bakirrayan/screen_support/Images/Animation_rotation_inclinaison.gif

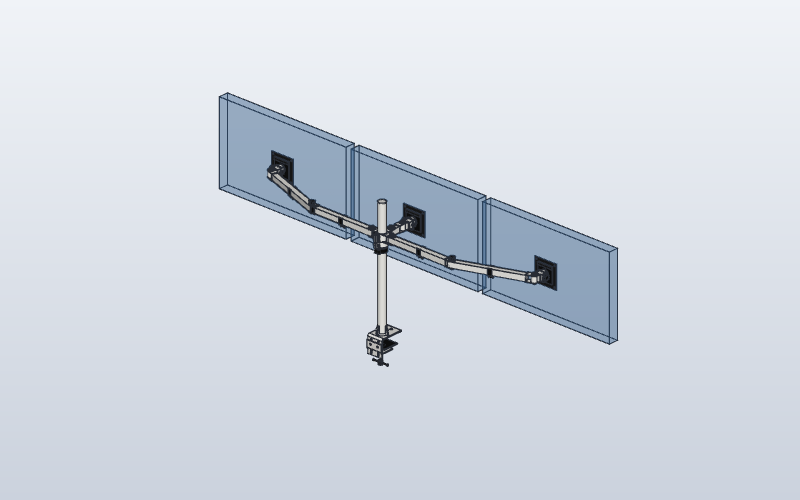
Images/Animation_rotation_inclinaison.gif
