bakirrayan/screen_support/Plans_Support_ecrans.pdf

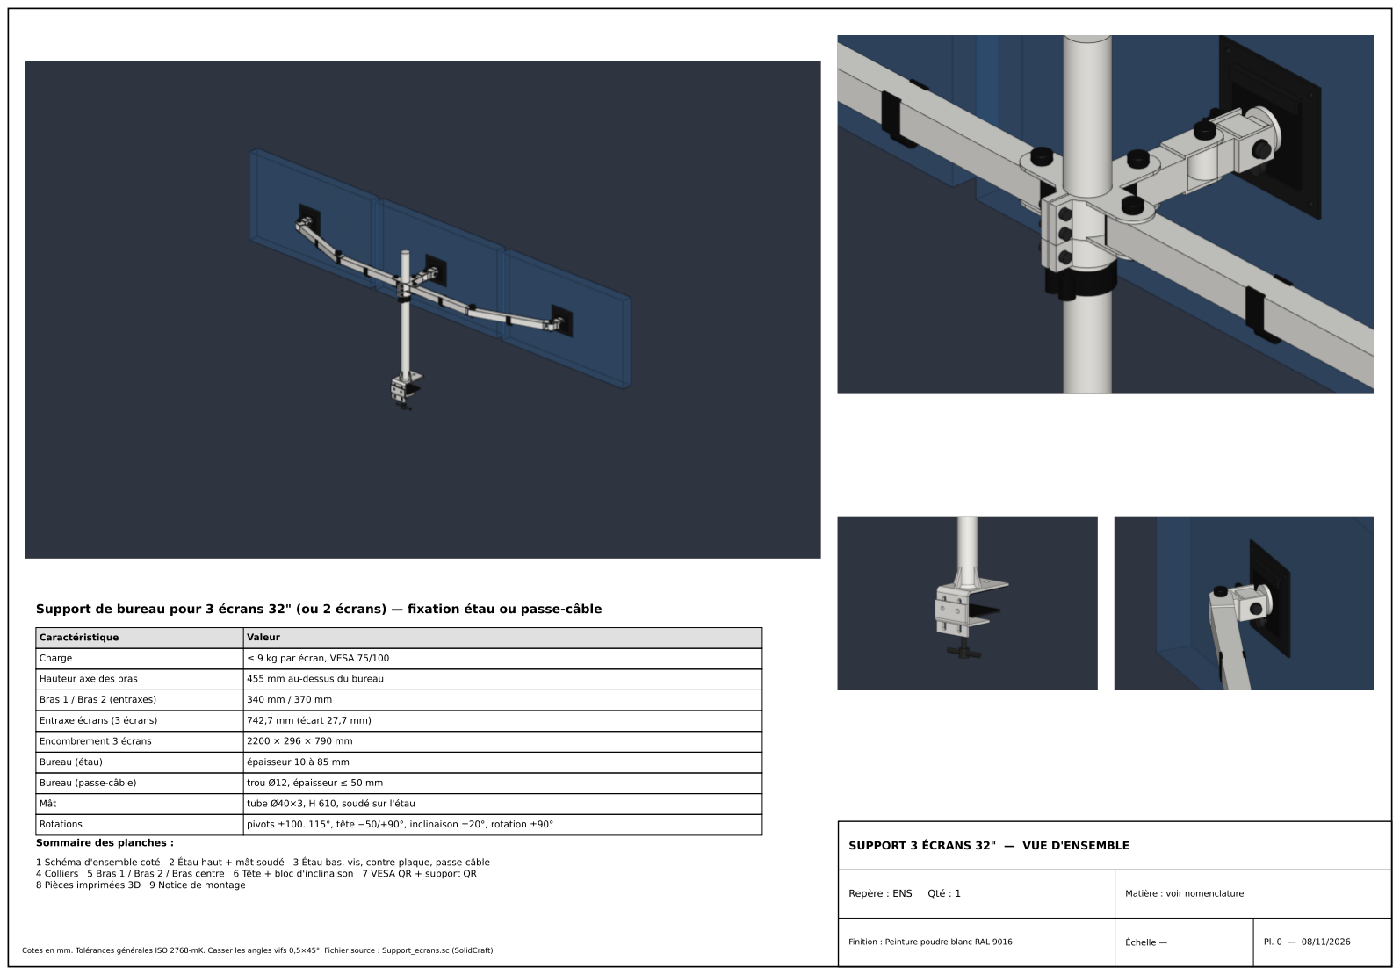
[picture p2: page 1]

### SUPPORT 3 ÉCRANS 32" — VUE D'ENSEMBLE

Repère : ENS Qté : 1 | Matière : voir nomenclature
Finition : Peinture poudre blanc RAL 9016 | Échelle — | Pl. 0 — 08/11/2026

Cotes en mm. Tolérances générales ISO 2768-mK. Casser les angles vifs 0,5×45°. Fichier source : Support_ecrans.sc (SolidCraft)

## Support de bureau pour 3 écrans 32" (ou 2 écrans) — fixation étau ou passe-câble

Caractéristique | Valeur
Charge | ≤ 9 kg par écran, VESA 75/100
Hauteur axe des bras | 455 mm au-dessus du bureau
Bras 1 / Bras 2 (entraxes) | 340 mm / 370 mm
Entraxe écrans (3 écrans) | 742,7 mm (écart 27,7 mm)
Encombrement 3 écrans | 2200 × 296 × 790 mm
Bureau (étau) | épaisseur 10 à 85 mm
Bureau (passe-câble) | trou Ø12, épaisseur ≤ 50 mm
Mât | tube Ø40×3, H 610, soudé sur l'étau
Rotations | pivots ±100..115°, tête −50/+90°, inclinaison ±20°, rotation ±90°

Sommaire des planches :

1 Schéma d'ensemble coté 2 Étau haut + mât soudé 3 Étau bas, vis, contre-plaque, passe-câble
4 Colliers 5 Bras 1 / Bras 2 / Bras centre 6 Tête + bloc d'inclinaison 7 VESA QR + support QR 8 Pièces imprimées 3D 9 Notice de montage

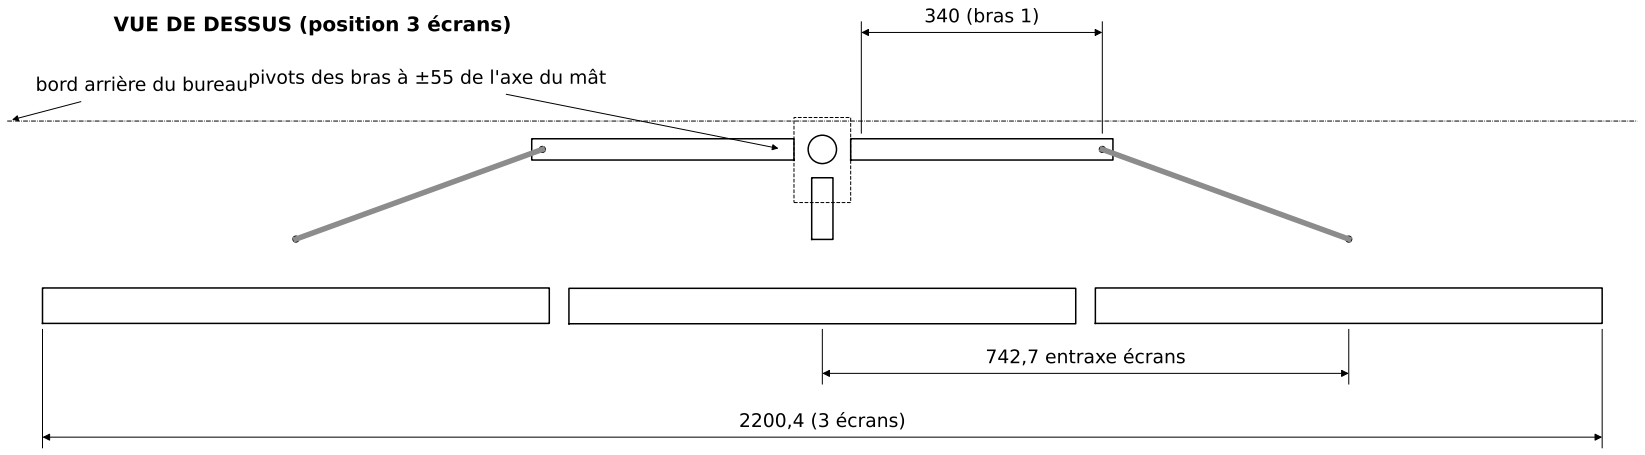
[picture p3: figure]
VUE DE DESSUS (position 3 écrans); bord arrière du bureau; 340 (bras 1); 2200,4 (3 écrans); 742,7 entraxe écrans; pivots des bras à ±55 de l'axe du mât
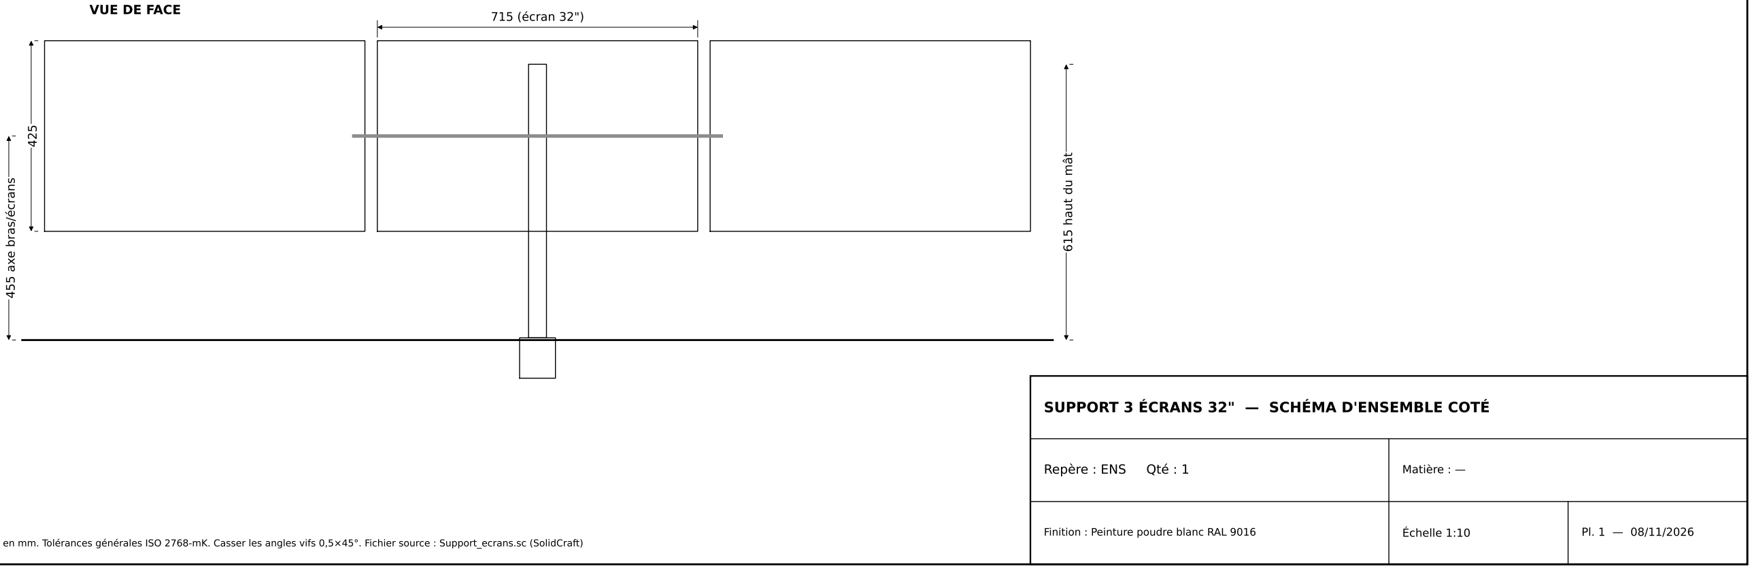
[picture p4: figure]
Repère : ENS; Qté : 1; Matière : —; VUE DE FACE; 455 axe bras/écrans; 615 haut du mât; 715 (écran 32")

### SUPPORT 3 ÉCRANS 32" — SCHÉMA D'ENSEMBLE COTÉ

Finition : Peinture poudre blanc RAL 9016 | Échelle 1:10 | Pl. 1 — 08/11/2026

Positions de réglage :

Articulation | 3 écrans | 2 écrans | Butées
Pivot mât D / G | 0° | +26,7° / −26,7° | −100 / +115 (G inversé)
Coude D / G | −20° / +20° | −113,4° / +113,4° | ±115°
Pivot tête D / G | +20° / −20° | +86,7° / −86,7° | −50 / +90 (G inversé)
Pivot mât centre | 0° | bras retiré | ±110°
Pivot tête centre | 0° | — | ±50°
Inclinaison | 0° | 0° | ±20°
Rotation écran | 0° | 0° | ±90° (portrait)

En mode 2 écrans, les écrans sont avancés de 90 mm vers
l'utilisateur (centres à ±380 mm) : les coudes passent 210 mm
derrière le bord du bureau — prévoir ce dégagement au mur.

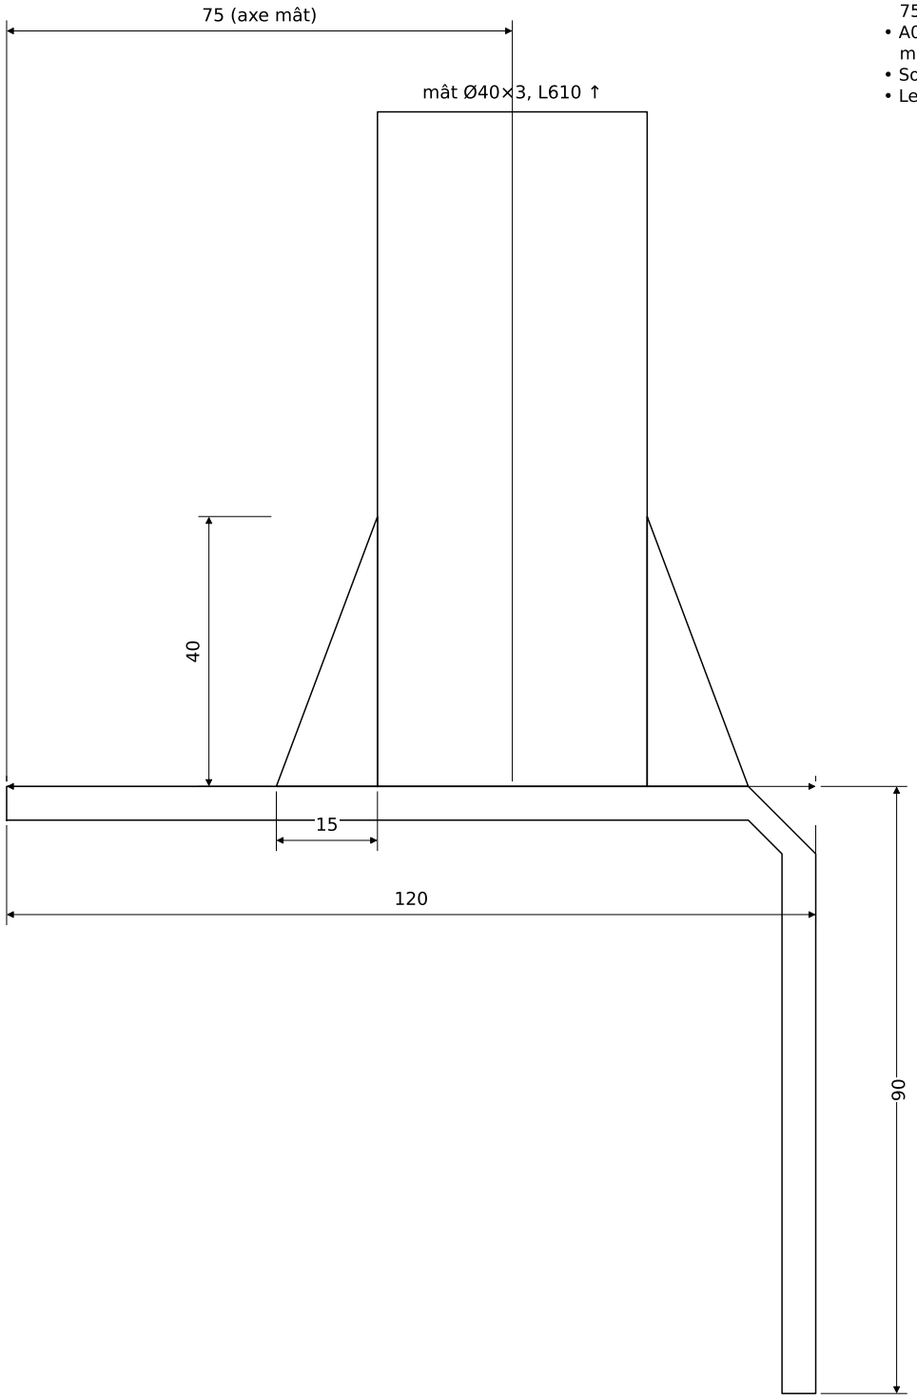
[picture p5: figure]
mât Ø40×3, L610 ↑; 75 (axe mât)
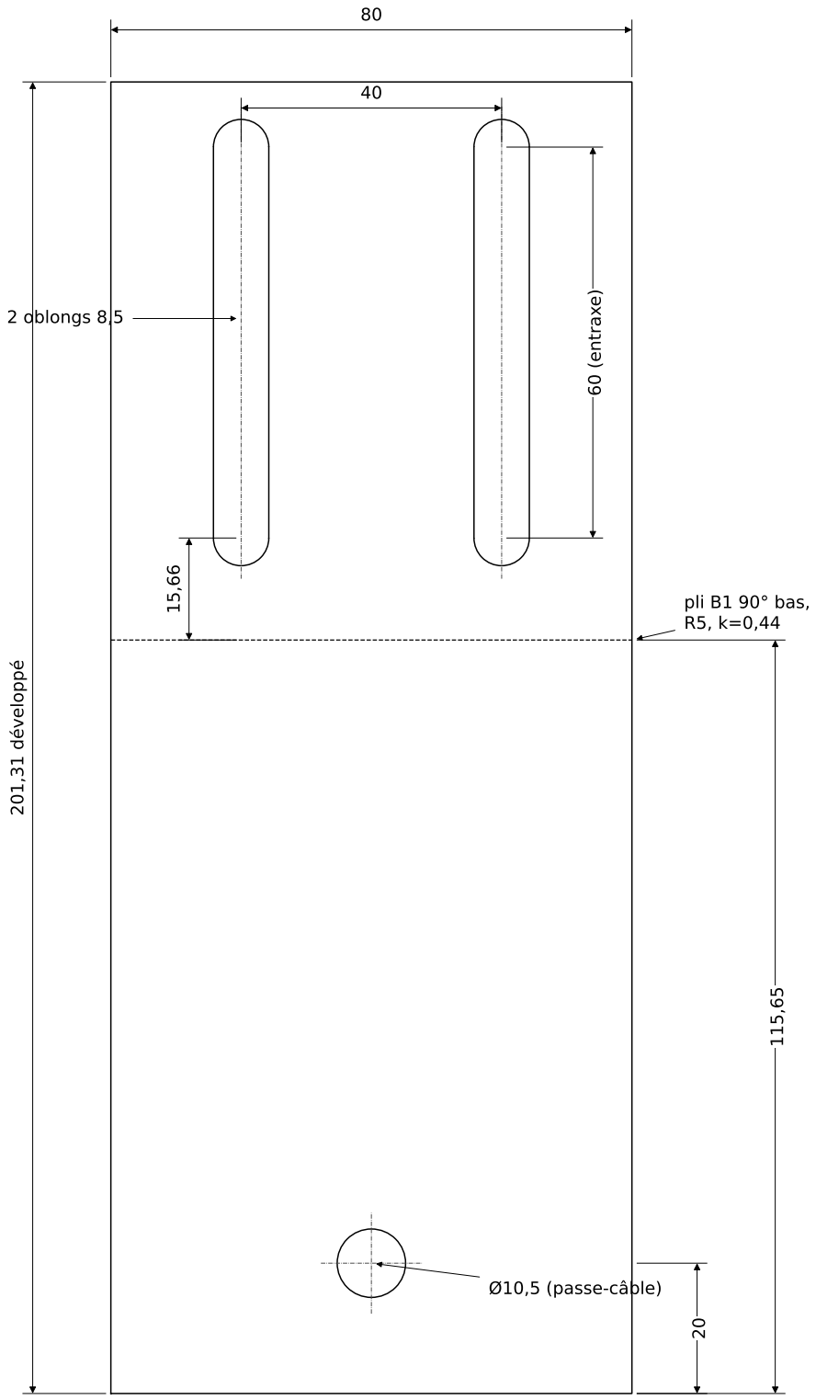
[picture p6: figure]
pli B1 90° bas, R5, k=0,44; 201,31 développé; 60 (entraxe); 2 oblongs 8,5; Ø10,5 (passe-câble)

### SUPPORT 3 ÉCRANS 32" — ÉTAU HAUT + MÂT SOUDÉ

Repère : A01-A04 | Qté : 1 | Matière : Acier S235
Finition : Peinture poudre blanc RAL 9016 | Échelle 1:1 (impr. A3) | Pl. 2 — 08/11/2026

A01 DÉVELOPPÉ — tôle 5 mm (fichier T01)

A01 PLIÉ + A03 MÂT + A04 GOUSSETS (vue de côté)

Notes de fabrication :
- A01 : laser tôle S235 ép. 5 (DXF T01),
pli 90° R5 vers le bas.
- A03 Mât : tube rond Ø40×3 S235, longueur 610, obturer le haut par un disque Ø34 ép. 5 soudé (ou bouchon plastique Ø40).
- Soudure mât/étau : cordon d'angle a=4 (gorge) tout autour. Axe du mât à
75 mm du bord côté utilisateur (45 mm du dos du pli), centré en largeur.
- A04 Goussets ×4 : triangles 15×40 ép. 5 (DXF T03) à 0/90/180/270°, soudés mât + plaque (a=3). Le gousset arrière s'arrête avant le pli.
- Souder AVANT peinture ; vérifier la perpendicularité du mât (≤0,5 mm / 600).
- Le trou Ø10,5 ne sert qu'en montage passe-câble.

### SUPPORT 3 ÉCRANS 32" — ÉTAU BAS, VIS, CONTRE-PLAQUE, PASSE-CÂBLE

Repère : A02, A14-A16 | Qté : 1 | Matière : Acier S235
Finition : Peinture poudre blanc RAL 9016 | Échelle 1:1 / 0,8:1 | Pl. 3 — 08/11/2026

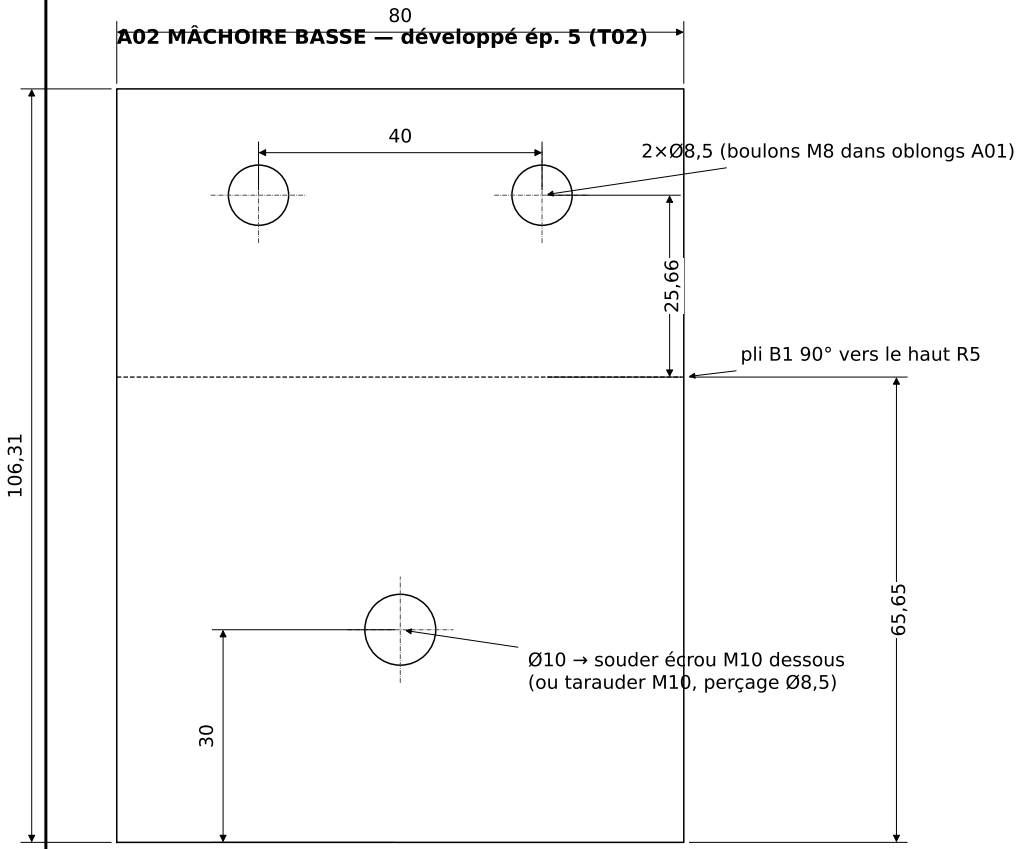
[picture p7: figure]
pli B1 90° vers le haut R5; Ø10 → souder écrou M10 dessous; (ou tarauder M10, perçage Ø8,5); 2×Ø8,5 (boulons M8 dans oblongs A01)

A02 MÂCHOIRE BASSE — développé ép. 5 (T02)

A16 VIS DE SERRAGE (ou achat : vis M10 à patin + poignée) 65 ⁽M¹⁰⁾

A14 CONTRE-PLAQUE 90×80×3 (T13)

90

80

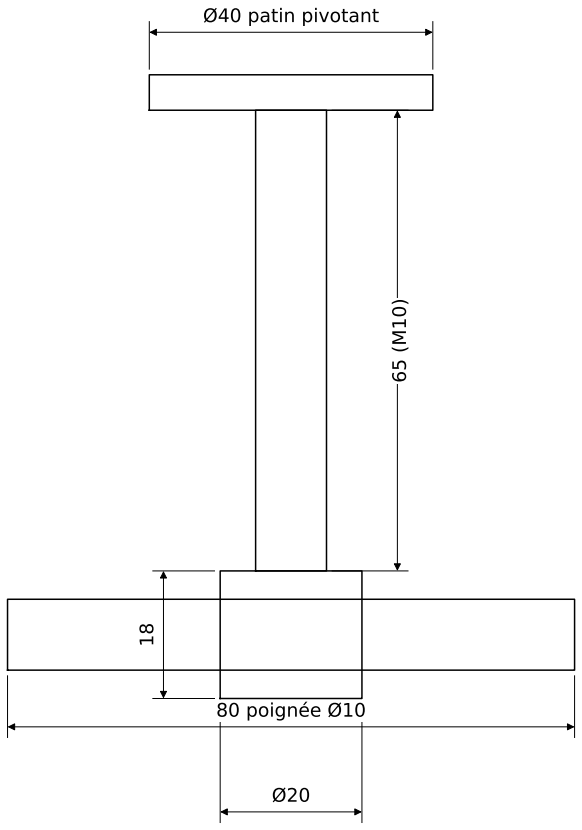
[picture p8: figure]
Ø40 patin pivotant; 80 poignée Ø10

+ patin caoutchouc/TPU 90×80×2 (P13) collé côté bureau

A15 PLAQUE PASSE-CÂBLE 80×60×5 (T14) 80

60

15

Montage étau : A02 se règle dans les oblongs de A01 (boulons M8×20 + écrous nylstop) pour un
bureau de 10 à 85 mm. Patin TPU 76×106×2 (P12) collé sous A01. Contre-plaque A14 entre vis et bureau. Montage passe-câble : tige filetée M10 L70 + 2 écrous M10 + rondelles, plaque A15 sous le bureau (trou Ø12).

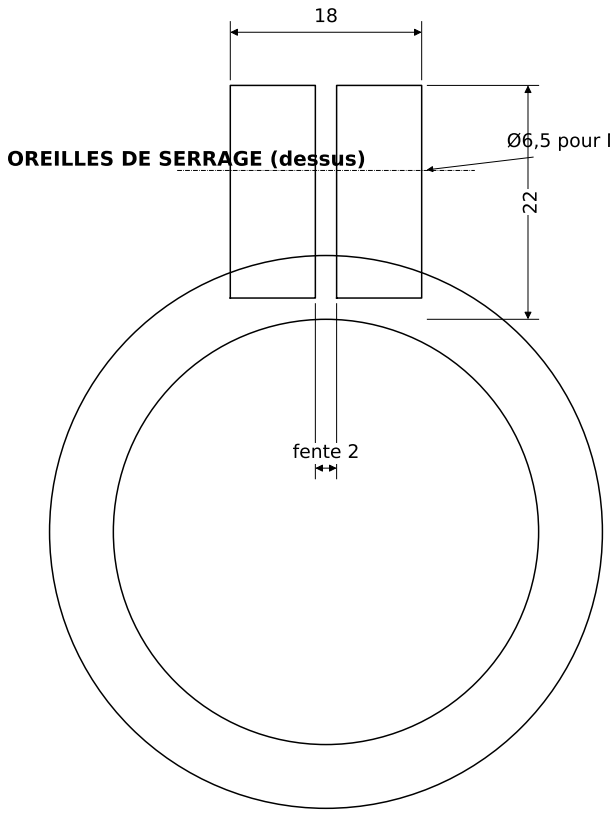
[picture p9: figure]
OREILLES DE SERRAGE (dessus); fente 2

### SUPPORT 3 ÉCRANS 32" — COLLIERS DE MÂT

Repère : A05, A06 | Qté : 1 + 1 | Matière : Acier S235
Finition : Peinture poudre blanc RAL 9016 | Échelle 1:1 / 1,5:1 | Pl. 4 — 08/11/2026

A05 CHAPE DE COLLIER ×2 — ép. 3 (T04) — vue de dessus

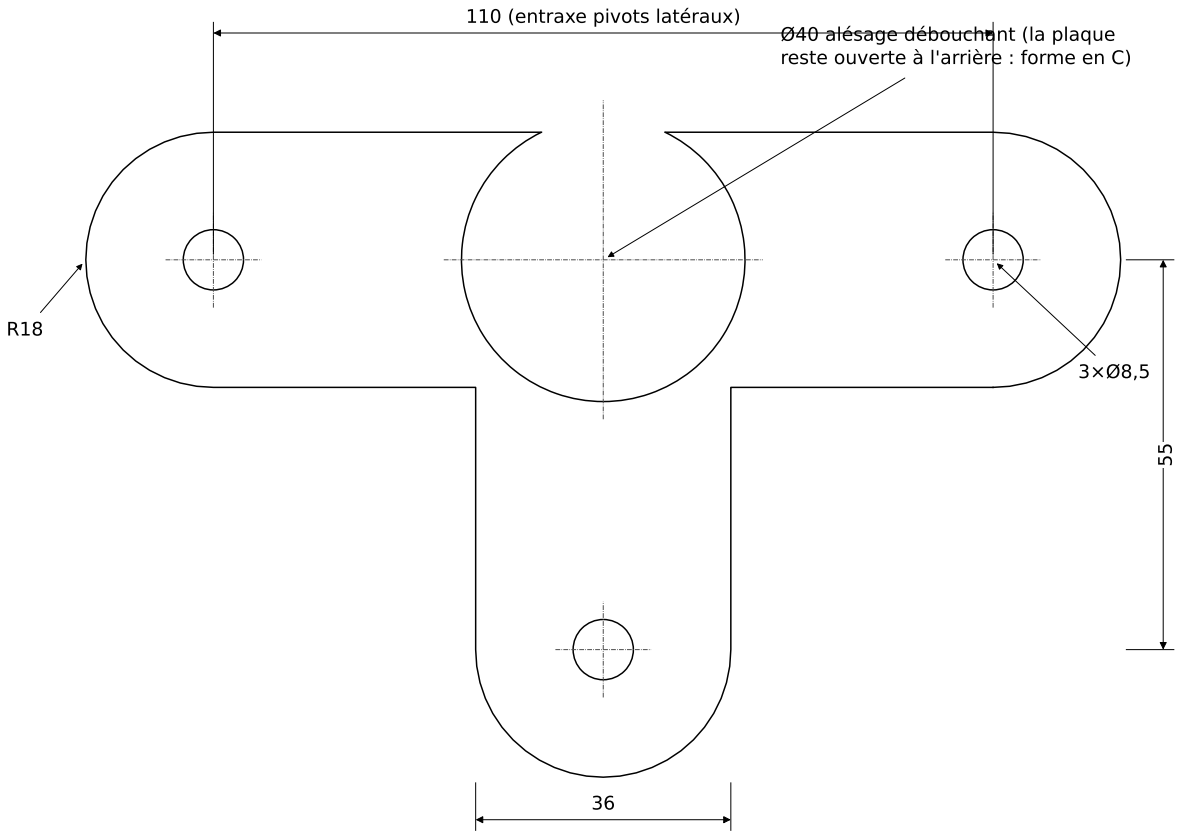
[picture p10: figure]
110 (entraxe pivots latéraux); Ø40 alésage débouchant (la plaque reste ouverte à l'arrière : forme en C)

A05 COLLIER HAUT soudé — vue de face (z)

36

Ø52 / Ø40 (tube 52×6)

30 (passage tube)

Ø6,5 pour M6 (×2 haut, ×1 bas)

Fabrication A05 (collier haut, porte-bras) :

- Bague : tube Ø52×6 (ou rond usiné) Ø52/Ø40 H30, entre les 2 chapes.
- 2 chapes T04 ép. 3 soudées sur les faces de la bague (H totale 36).
- Oreilles : plat 18×20×36 soudé à l'arrière (axe +Y), puis scier
la fente de 2 mm à travers oreilles + bague (après soudure).
- Percer 2×Ø6,5 à 9 et 27 du bas, à 34 mm de l'axe du mât.
- Les 3 pivots Ø8,5 reçoivent les vis M8 + bagues nylon des bras.

Fabrication A06 (collier bas, butée) :
- Bague Ø52/Ø40 H25 + oreilles 18×20×25, fente 2 mm,
1 trou Ø6,5 à 12,5 du bas. Monté juste sous A05.
- Serrer M6 à 8 N·m ; ajouter une bande de chambre à air dans l'alésage pour éviter de marquer le mât.

### SUPPORT 3 ÉCRANS 32" — BRAS 1, BRAS 2, BRAS CENTRE

Repère : A07, A08, A09 | Qté : 2 + 2 + 1 | Matière : Tube carré S235 30×30×2 + tôle 3
Finition : Peinture poudre blanc RAL 9016 | Échelle 1:2 / 1:1 / 2:1 | Pl. 5 — 08/11/2026

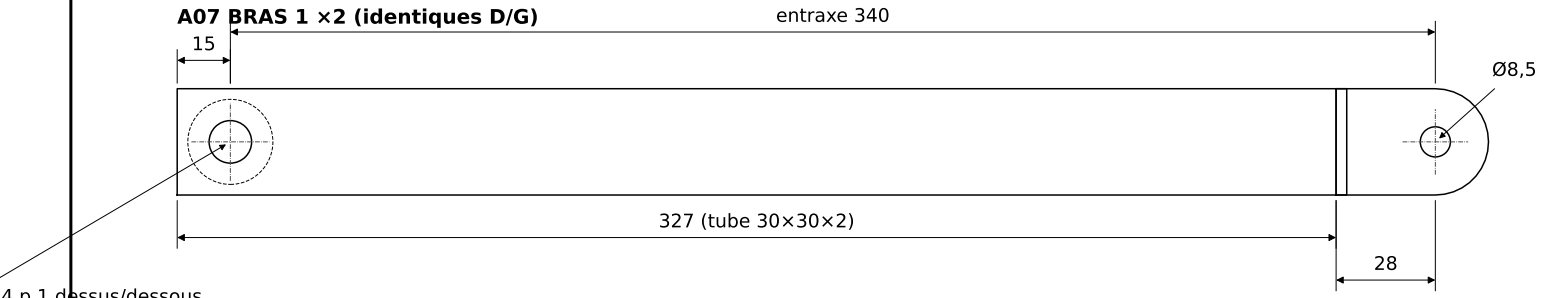
[picture p11: figure]
A07 BRAS 1 ×2 (identiques D/G); 327 (tube 30×30×2); entraxe 340

Ø12 traversant + lamage Ø24 p.1 dessus/dessous

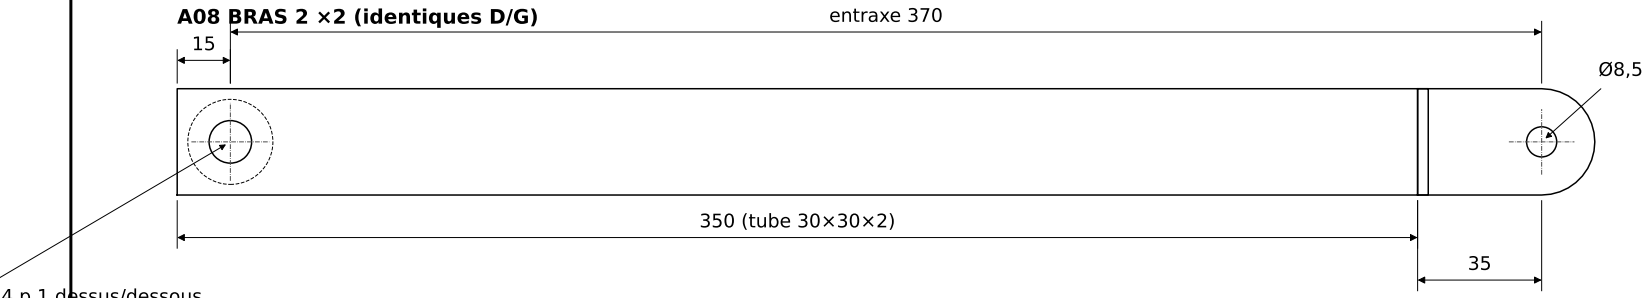
[picture p12: figure]
A08 BRAS 2 ×2 (identiques D/G); 350 (tube 30×30×2); entraxe 370

Ø12 traversant + lamage Ø24 p.1 dessus/dessous

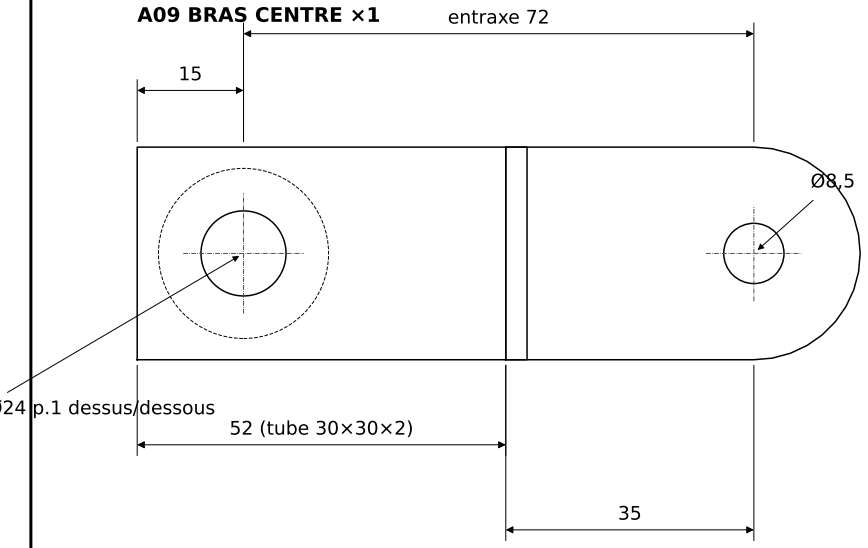
[picture p13: figure]
A09 BRAS CENTRE ×1; 52 (tube 30×30×2); entraxe 72

Ø12 traversant + lamage Ø24 p.1 dessus/dessous

COUPE CHAPE (dos + 2 ailes)

30 int.
36

Fabrication :

- Tubes carrés 30×30×2 S235 coupés d'équerre ; extrémité libre fermée par embout plastique P08 (côté pivot).
- Chape = 2 ailes ép. 3 (T05 pour bras 1 : axe à 28 ; T06 pour bras 2
et centre : axe à 35) + fond 30×30 ép. 3 (T07), soudés au bout du tube. Écartement intérieur des ailes : 30 mm exactement (gabarit de soudage).
- Trou pivot Ø12 à 15 mm du bout libre, traversant les 2 parois horizontales, lamage Ø24 profondeur 1 sur chaque face (patins P04).
- Bague nylon P01 Ø12/Ø8 × 30 dans le tube (sert d'entretoise :
empêche d'écraser le tube au serrage).
- Clips de câbles P11 : bras 1 à 180 mm, bras 2 à 190 mm du pivot.

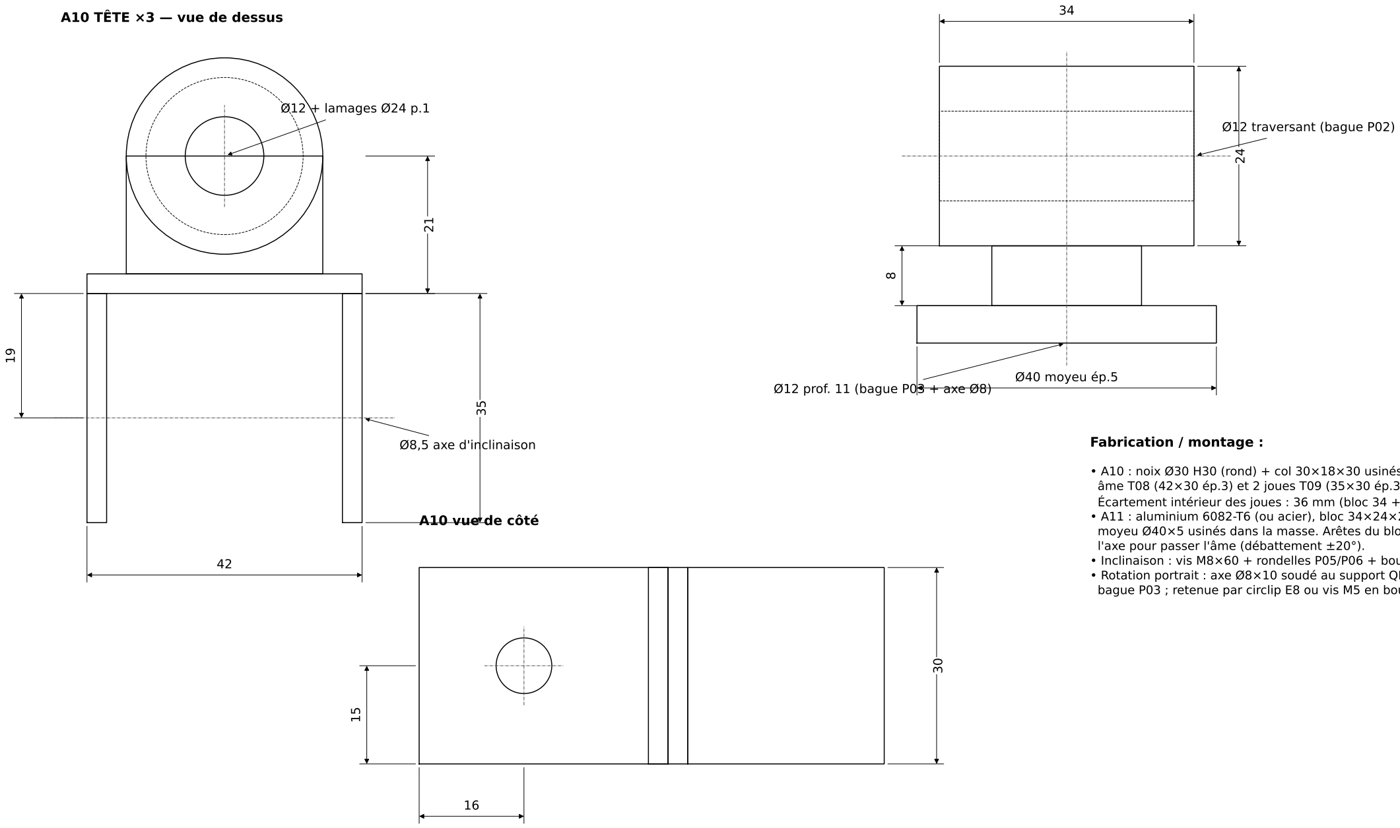
[picture p14: figure]
A10 TÊTE ×3 — vue de dessus; Ø12 + lamages Ø24 p.1; Ø8,5 axe d'inclinaison; A10 vue de côté; Ø40 moyeu ép.5; Ø12 traversant (bague P02); Ø12 prof. 11 (bague P03 + axe Ø8); Fabrication / montage :

### SUPPORT 3 ÉCRANS 32" — TÊTE PIVOTANTE + BLOC D'INCLINAISON

Repère : A10, A11 | Qté : 3 + 3 | Matière : Acier S235 / Alu 6082
Finition : Peinture poudre blanc RAL 9016 | Échelle 1,4:1 / 1,6:1 | Pl. 6 — 08/11/2026

A11 BLOC D'INCLINAISON ×3 (usiné) — dessus

- A10 : noix Ø30 H30 (rond) + col 30×18×30 usinés d'une pièce (ou soudés), âme T08 (42×30 ép.3) et 2 joues T09 (35×30 ép.3, Ø8,5) soudées en U. Écartement intérieur des joues : 36 mm (bloc 34 + 2 rondelles 1 mm).
- A11 : aluminium 6082-T6 (ou acier), bloc 34×24×24 + col 20×8×20 + moyeu Ø40×5 usinés dans la masse. Arêtes du bloc à 17 mm max de l'axe pour passer l'âme (débattement ±20°).
- Inclinaison : vis M8×60 + rondelles P05/P06 + bouton P09 (écrou M8 noyé).
- Rotation portrait : axe Ø8×10 soudé au support QR, tourne dans la
bague P03 ; retenue par circlip E8 ou vis M5 en bout (à ajouter).

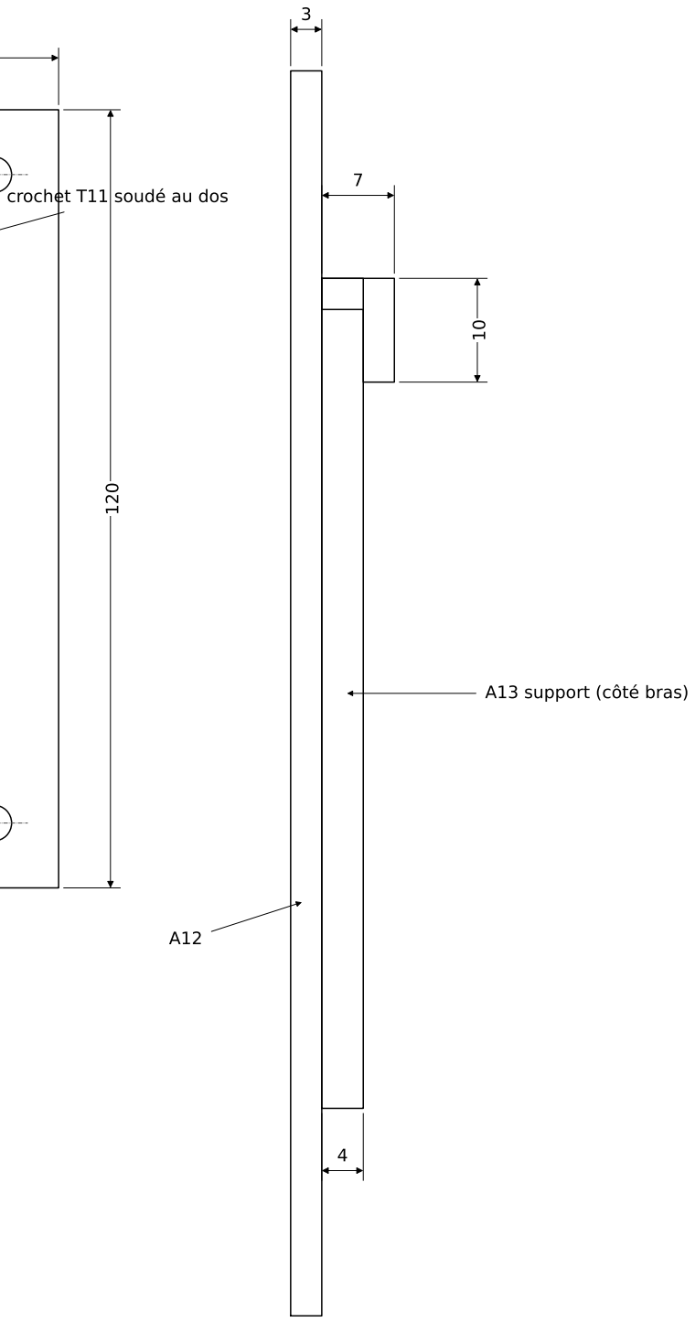
[picture p15: figure]
crochet T11 soudé au dos; A13 support (côté bras)
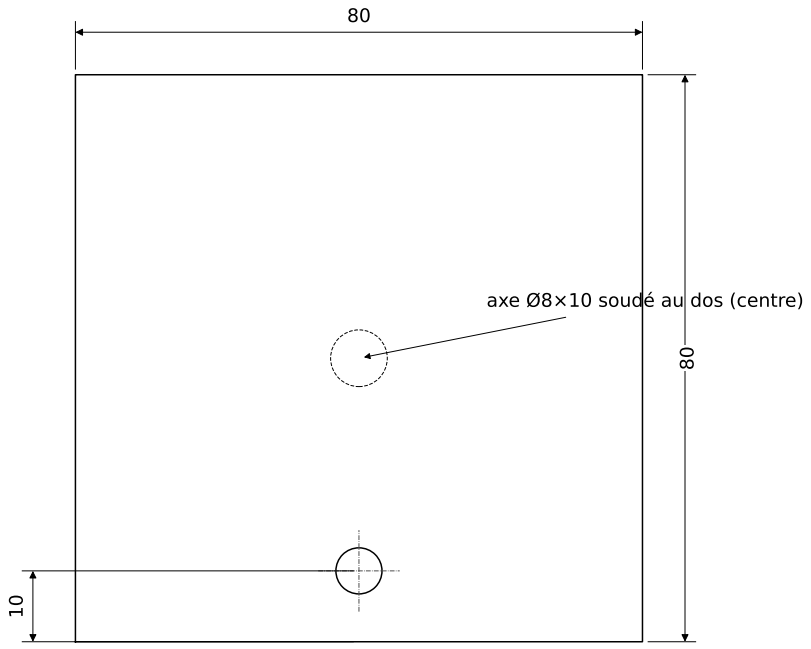
[picture p16: figure]
axe Ø8×10 soudé au dos (centre)

### SUPPORT 3 ÉCRANS 32" — FIXATION VESA À DÉGAGEMENT RAPIDE

Repère : A12, A13 | Qté : 3 + 3 | Matière : Acier S235
Finition : Peinture poudre blanc RAL 9016 | Échelle 1:1 / 1,6:1 | Pl. 7 — 08/11/2026

A12 PLAQUE VESA ×3 (côté écran) — ép. 3 (T10)

COUPE DU CROCHET (A12 + A13)

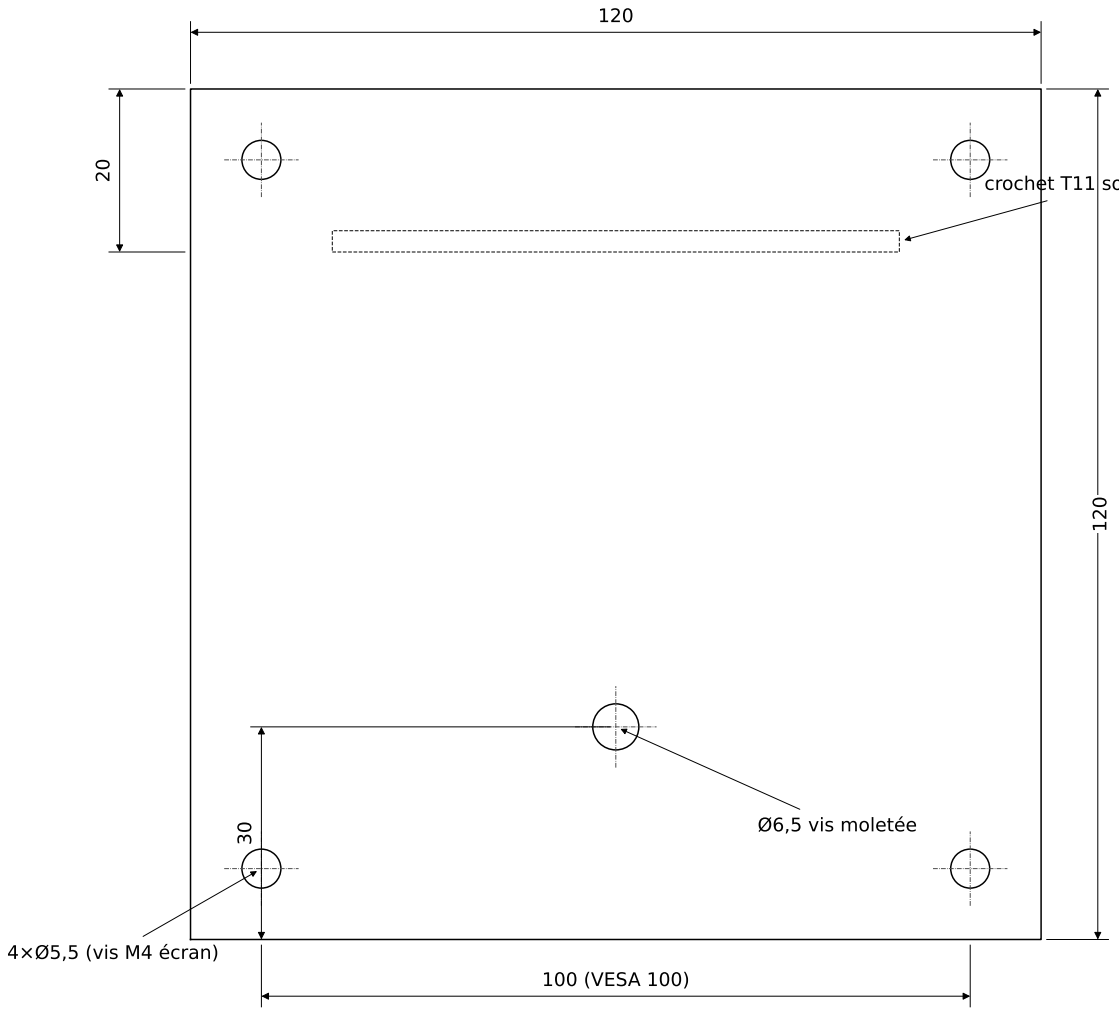
[picture p17: figure]
100 (VESA 100); 4×Ø5,5 (vis M4 écran); Ø6,5 vis moletée

A13 SUPPORT QR ×3 — ép. 4 (T12)

Principe : la plaque A12 reste vissée sur l'écran (VESA 100, ou 75 en ajoutant 4 trous à 75).
On accroche le crochet sur le bord supérieur du support A13, puis on bloque avec la vis moletée M6 (P-QR). Pour VESA 75 : percer 4×Ø5,5 sur un carré de 75 centré.

### SUPPORT 3 ÉCRANS 32" — PIÈCES IMPRIMÉES 3D

Repère : P01-P13 Qté : voir tableau | Matière : PETG / PA / TPU
Finition : Noir | Échelle — | Pl. 8 — 08/11/2026
Rep | Pièce | Qté | Dimensions | Matière | Remplissage / orientation
P01 | Bague pivot | 8 | Ø12 / Ø8 × 30 | PA12 / PETG | 100 %, debout
P02 | Bague inclinaison | 3 | Ø12 / Ø8 × 34 | PA12 / PETG | 100 %, debout
P03 | Bague rotation | 3 | Ø12 / Ø8 × 10 | PA12 / PETG | 100 %, debout
P04 | Patin de friction | 16 | Ø24 / Ø12 × 1 | PETG / PA | 100 %, à plat
P05 | Rondelle de friction | 22 | Ø16 / Ø8,5 × 2 | PETG / PA | 100 %, à plat
P06 | Rondelle de butée | 6 | Ø16 / Ø8,5 × 1 | PETG / PA | 100 %, à plat
P07 | Cache de vis | 6 | Ø18 × 7 (cavité Ø13,5) | PETG | 30 %, dôme en haut
P08 | Embout de tube | 5 | 30×30 col 2 + bouchon 25×25×8 | PETG / TPU | 30 %, col à plat
P09 | Bouton de serrage | 5 | Ø28 × 12, 6 lobes | PETG | 40 %, cavité en bas
P10 | Clip câbles mât | 1 | Ø48/Ø40 × 20, 2 boucles Ø9 | PETG | 30 %, debout
P11 | Clip câbles bras | 4 | U 33 × 49,5 × 20, boucle Ø11 | PETG | 30 %, sur le côté
P12 | Patin d'étau | 1 | 76 × 106 × 2, trou Ø12 | TPU 95A | 100 %, à plat
P13 | Patin contre-plaque | 1 | 90 × 80 × 2 | TPU 95A | 100 %, à plat

Réglages d'impression conseillés :

- Buse 0,4, couches 0,2 (0,12 pour P04/P06 de 1 mm). Périmètres 4 minimum sur les bagues et boutons.
- Bagues P01-P03 : imprimer debout (axe vertical), PA12/PA-CF ou PETG ; aléser à Ø8,0 (forêt 8 mm à la main)
et vérifier Ø12,0 extérieur (ajuster le facteur d'expansion horizontale si l'emmanchement est trop dur).
- Patins P04 et rondelles P05/P06 : PETG ou PA (meilleur frottement : PA/POM usiné ou rondelles PTFE du commerce).
- Boutons P09 : noyer un écrou M8 (h 6,5) dans la cavité Ø13,5 — pause à 5,5 mm ou coller à l'époxy.
- Patins P12/P13 : TPU 95A, 100 % ; à coller (colle contact) sous l'étau et sur la contre-plaque.
- Les STL sont dans le dossier STL ; le nom indique la quantité (_x8 = 8 pièces).

### SUPPORT 3 ÉCRANS 32" — NOTICE DE MONTAGE

Repère : — Qté : — | Matière : —
Finition : Peinture poudre blanc RAL 9016 | Échelle — | Pl. 9 — 08/11/2026
1. PRÉPARATION
Découper / plier / souder les pièces A01-A16 (planches 2-7), ébavurer, peindre. Imprimer P01-P13. Vérifier : mât perpendiculaire à l'étau, écartement des chapes 30 mm, joues de tête 36 mm.
2. FIXATION AU BUREAU (choisir)
Étau : coller P12 sous A01. Poser A01 sur le bureau (dos du pli contre le chant arrière), positionner A02
dans les oblongs pour l'épaisseur du bureau, serrer 2 boulons M8×20 (20 N·m). Poser A14+P13 sous le bureau,
visser A16 jusqu'au contact puis serrer fermement à la main (poignée en T).
Passe-câble : percer Ø12 dans le bureau, passer la tige M10 par le trou Ø10,5 de A01, plaque A15 dessous, écrous M10 (25 N·m).
3. COLLIERS
Glisser A06 (collier bas) puis A05 (collier haut) sur le mât. Régler la hauteur (axe des bras 455 mm),
serrer A06 (M6, 8 N·m), poser A05 dessus, l'orienter (pivot central vers l'utilisateur), serrer ses 2 vis M6.
4. BRAS
Dans chaque pivot : bague P01 dans le tube, patins P04 dans les lamages, rondelles P05 sous tête et écrou. Bras 1 D/G dans les chapes latérales du collier, bras centre dans la chape avant (vis M8×50 + écrou nylstop). Bras 2 dans la chape du coude (vis M8×50 + bouton P09). Têtes A10 dans les chapes de bout (M8×50 + nylstop). Serrage pivots : jusqu'à ce que le bras tienne sa position avec l'écran (≈ 6-8 N·m) — ajuster ensuite.
5. INCLINAISON ET ROTATION
Bloc A11 entre les joues de la tête avec bague P02 et 2 rondelles P06 ; vis M8×60, rondelles P05, bouton P09. Bague P03 dans le moyeu, axe du support A13 dedans, retenir par circlip E8.
6. ÉCRANS
Visser A12 sur chaque écran (4 vis M4×10-16 selon l'écran). Accrocher A12 sur A13, bloquer la vis moletée M6. Régler l'inclinaison avec le bouton (±20°), la rotation portrait (±90°), puis les pivots.
7. FINITIONS
Embouts P08 sur les extrémités ouvertes des tubes, caches P07 sur les têtes de vis visibles,
clips P10 (mât) et P11 (bras) pour les câbles.

SÉCURITÉ : charge max 9 kg par écran. Monter les écrans à deux. Bureau en bois massif/aggloméré ≥ 18 mm (pas de verre). Revérifier les serrages après 1 semaine. Ne pas déplacer le support chargé.

Vis | Couple
M6 colliers | 8 N·m
M8 boulons étau | 20 N·m
M8 pivots | 6-8 N·m (réglage)
M10 passe-câble | 25 N·m
Vis VESA M4 | 1,5 N·m
