bakirrayan/screen_support/Images/Detail_collier_bras.png

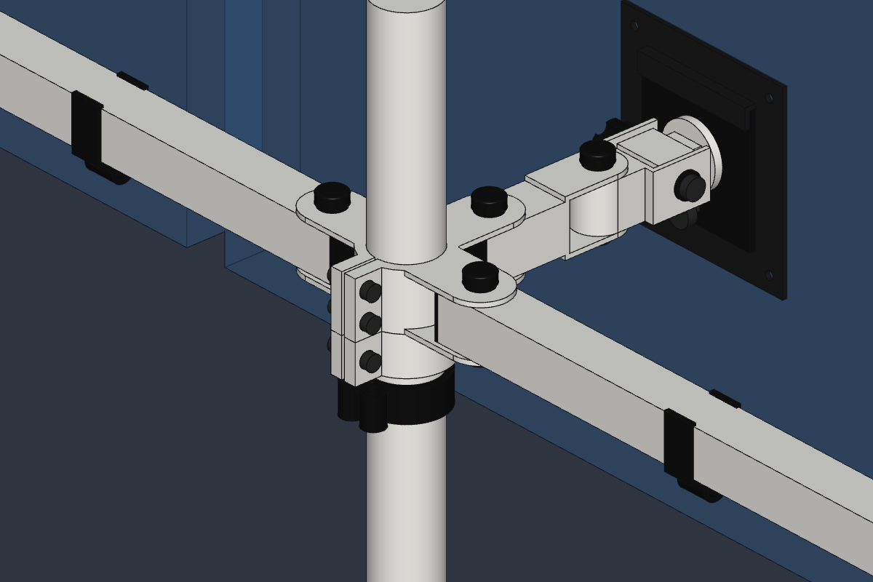
Images/Detail_collier_bras.png
