bakirrayan/screen_support/Images/Detail_etau.png

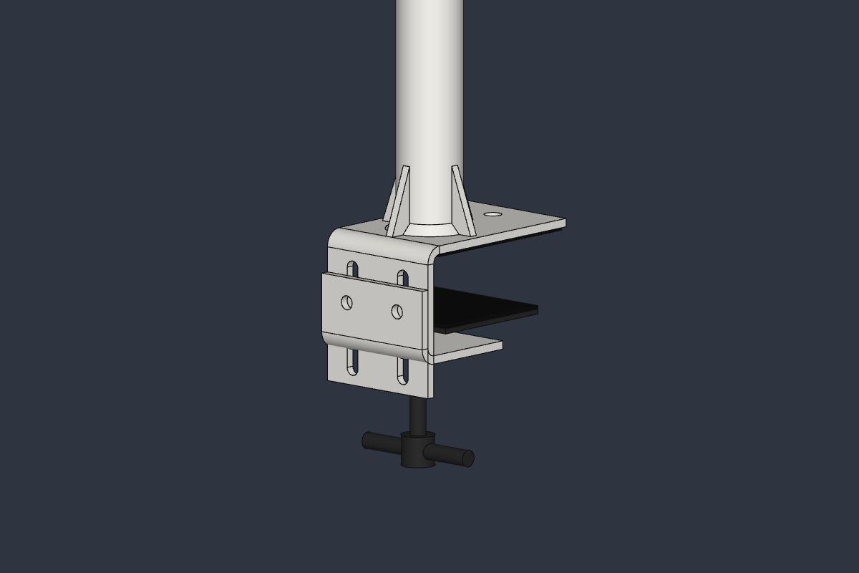
Images/Detail_etau.png
