bakirrayan/screen_support/Images/Detail_tete_VESA.png

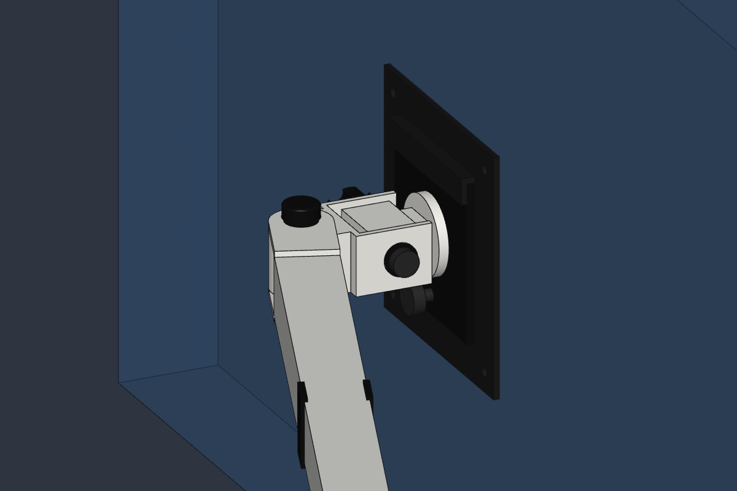
Images/Detail_tete_VESA.png
