bakirrayan/screen_support/Images/Vue_ensemble_3_ecrans.png

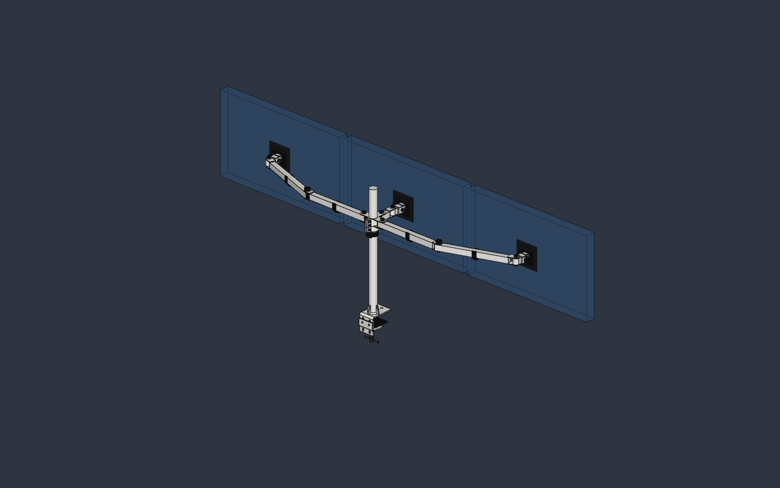
Images/Vue_ensemble_3_ecrans.png
