bakirrayan/screen_support/Nomenclature_Support_ecrans.xlsx

Sheet: Nomenclature
Rep | Désignation | Qté | Matière | Volume unitaire (cm³) | Densité (g/cm³) | Masse unit. (g) | Masse totale (g) | Brut / dimensions | Procédé | Fichier
A01 | Étau haut (plaque + retour plié) | 1 | Acier S235 | 74.6 |  |  |  | Tôle ép. 5 — flan 80 × 201,31 — 1 pli 90° R5 | Laser + pliage + soudure mât | DXF T01 / Pl. 2
A02 | Mâchoire basse d'étau | 1 | Acier S235 | 41.8 |  |  |  | Tôle ép. 5 — flan 80 × 106,31 — 1 pli 90° R5 | Laser + pliage + écrou M10 soudé | DXF T02 / Pl. 3
A03 | Mât | 1 | Acier S235 | 217.2 |  |  |  | Tube rond Ø40 × 3, L 610 + disque Ø34 ép.5 | Scie + soudure | Pl. 2
A04 | Gousset de mât | 4 | Acier S235 | 1.4 |  |  |  | Tôle ép. 5 — triangle 15 × 40 | Laser + soudure | DXF T03
A05 | Collier haut porte-bras | 1 | Acier S235 | 67.7 |  |  |  | Bague Ø52/40 H30 + 2 chapes ép.3 + oreilles 18×20×36 | Laser + soudure + sciage fente | DXF T04 / Pl. 4
A06 | Collier bas (butée) | 1 | Acier S235 | 27.5 |  |  |  | Bague Ø52/40 H25 + oreilles 18×20×25 | Scie + soudure + sciage fente | Pl. 4
A07 | Bras 1 (D/G identiques) | 2 | Acier S235 | 81.6 |  |  |  | Tube carré 30×30×2 L327 + chape (2 ailes T05 + fond T07) | Scie + perçage + soudure | DXF T05/T07 / Pl. 5
A08 | Bras 2 (D/G identiques) | 2 | Acier S235 | 88.0 |  |  |  | Tube carré 30×30×2 L350 + chape (2 ailes T06 + fond T07) | Scie + perçage + soudure | DXF T06/T07 / Pl. 5
A09 | Bras centre | 1 | Acier S235 | 21.3 |  |  |  | Tube carré 30×30×2 L52 + chape (2 ailes T06 + fond T07) | Scie + perçage + soudure | DXF T06/T07 / Pl. 5
A10 | Tête pivotante | 3 | Acier S235 | 32.5 |  |  |  | Noix Ø30 H30 + col 30×18×30 + âme T08 + 2 joues T09 | Usinage + laser + soudure | DXF T08/T09 / Pl. 6
A11 | Bloc d'inclinaison | 3 | Aluminium 6082-T6 | 24.0 |  |  |  | Rond Ø40 L37 (bloc 34×24×24 + col + moyeu Ø40×5) | Usinage | Pl. 6
A12 | Plaque VESA à crochet (écran) | 3 | Acier S235 | 46.9 |  |  |  | Tôle ép.3 120×120 + crochet T11 | Laser + pliage + soudure | DXF T10/T11 / Pl. 7
A13 | Support QR + axe Ø8×10 | 3 | Acier S235 | 26.0 |  |  |  | Tôle ép.4 80×80 + rond Ø8 L10 ; taraudage M6 | Laser + soudure + taraudage | DXF T12 / Pl. 7
A14 | Contre-plaque d'étau | 1 | Acier S235 | 21.6 |  |  |  | Tôle ép.3 90×80 | Laser | DXF T13 / Pl. 3
A15 | Plaque passe-câble (option) | 1 | Acier S235 | 23.6 |  |  |  | Tôle ép.5 80×60, Ø10,5 | Laser | DXF T14 / Pl. 3
A16 | Vis de serrage à poignée en T | 1 | Acier S235 | 21.8 |  |  |  | M10 L65 + patin Ø40 + poignée Ø10×80 (ou achat) | Achat ou usinage | Pl. 3
P01 | Bague de pivot | 8 | PA12 / Nylon | 1.9 |  |  |  | Ø12/Ø8 × 30 | Impression 3D | STL P01
P02 | Bague d'inclinaison | 3 | PA12 / Nylon | 2.1 |  |  |  | Ø12/Ø8 × 34 | Impression 3D | STL P02
P03 | Bague de rotation | 3 | PA12 / Nylon | 0.6 |  |  |  | Ø12/Ø8 × 10 | Impression 3D | STL P03
P04 | Patin de friction | 16 | PETG | 0.3 |  |  |  | Ø24/Ø12 × 1 | Impression 3D | STL P04
P05 | Rondelle de friction | 22 | PETG | 0.3 |  |  |  | Ø16/Ø8,5 × 2 | Impression 3D | STL P05
P06 | Rondelle de butée | 6 | PETG | 0.1 |  |  |  | Ø16/Ø8,5 × 1 | Impression 3D | STL P06
P07 | Cache de vis | 6 | PETG | 1.0 |  |  |  | Ø18 × 7 | Impression 3D | STL P07
P08 | Embout de tube | 5 | PETG | 6.8 |  |  |  | 30×30, bouchon 25×25×8 | Impression 3D | STL P08
P09 | Bouton de serrage | 5 | PETG | 4.9 |  |  |  | Ø28 × 12, 6 lobes (écrou M8 noyé) | Impression 3D | STL P09
P10 | Clip de câbles de mât | 1 | PETG | 14.2 |  |  |  | Ø48/Ø40 × 20 | Impression 3D | STL P10
P11 | Clip de câbles de bras | 4 | PETG | 6.0 |  |  |  | U 33 × 49,5 × 20 | Impression 3D | STL P11
P12 | Patin d'étau | 1 | TPU 95A | 15.9 |  |  |  | 76 × 106 × 2 | Impression 3D | STL P12
P13 | Patin de contre-plaque | 1 | TPU 95A | 14.4 |  |  |  | 90 × 80 × 2 | Impression 3D | STL P13
 | TOTAL acier (kg)
 | TOTAL aluminium (kg)
 | TOTAL plastiques (kg)
 | MASSE DU SUPPORT (kg, sans visserie)
 | Note : A15 (passe-câble) et A02/A14/A16 (étau) sont alternatifs — total ci-dessus = les deux montages.

Sheet: Matieres
Matière | Densité (g/cm³) | Remarque
Acier S235 | 7.85 | Tôles, tubes, plats — peinture poudre RAL 9016
Aluminium 6082-T6 | 2.7 | Blocs d'inclinaison usinés
PETG | 1.27 | Pièces imprimées
PA12 / Nylon | 1.01 | Bagues imprimées (ou PETG)
TPU 95A | 1.21 | Patins anti-dérapants
Valeurs en bleu = hypothèses modifiables (densités usuelles).

Sheet: Visserie
Qté | Désignation | Norme | Utilisation
8 | Vis M8 × 50 tête bombée 6 pans creux | ISO 7380 cl. 10.9 | Pivots verticaux (3 mât, 2 coudes, 3 têtes)
3 | Vis M8 × 60 tête bombée 6 pans creux | ISO 7380 cl. 10.9 | Axes d'inclinaison
8 | Écrou M8 autofreiné (nylstop) | ISO 10511 | Pivots mât + têtes (6) + boulons d'étau (2)
5 | Écrou M8 hexagonal | ISO 4032 | Noyés dans les boutons P09 (2 coudes + 3 inclinaisons)
2 | Vis M8 × 20 tête hexagonale | ISO 4017 | Réglage mâchoire A02 dans les oblongs A01
4 | Rondelle M8 large | ISO 7093 | Boulons d'étau
3 | Vis M6 × 30 CHC | ISO 4762 | Serrage colliers (2 haut, 1 bas)
3 | Écrou M6 autofreiné | ISO 10511 | Serrage colliers
1 | Écrou M10 à souder | DIN 929 | Sous la mâchoire A02 (vis de serrage)
3 | Vis moletée M6 × 12 | DIN 464 | Blocage QR (taraudage M6 dans A13)
3 | Circlip pour arbre Ø8 | DIN 6799 / DIN 471 | Retenue axe de rotation écran
12 | Vis M4 × 12 (selon écran, 10-16) | ISO 7380 | Fixation VESA sur écrans
1 | Tige filetée M10 × 70 (option passe-câble) | DIN 976 | Montage passe-câble
2 | Écrou M10 + rondelle large (option) | ISO 4032 / ISO 7093 | Montage passe-câble

Sheet: Debit
Brut | Pièce | Qté | Longueur ou L (mm) | Largeur (mm) | Total (m ou m²) | Unité
Tube carré 30×30×2 | A07 Bras 1 | 2 | 327 |  |  | m
Tube carré 30×30×2 | A08 Bras 2 | 2 | 350 |  |  | m
Tube carré 30×30×2 | A09 Bras centre | 1 | 52 |  |  | m
Tube rond Ø40×3 | A03 Mât | 1 | 610 |  |  | m
Tube rond Ø52×6 | A05/A06 bagues | 1 | 30 |  |  | m
Tube rond Ø52×6 | A06 bague | 1 | 25 |  |  | m
Plat 20×18 | Oreilles A05 + A06 | 1 | 61 |  |  | m
Rond Ø30 | Noix de tête A10 | 3 | 30 |  |  | m
Rond alu Ø40 | A11 blocs (L37 + sciage) | 3 | 40 |  |  | m
Tôle 5 mm | A01 flan | 1 | 201.31 | 80 |  | m²
Tôle 5 mm | A02 flan | 1 | 106.31 | 80 |  | m²
Tôle 5 mm | A04 goussets | 4 | 40 | 15 |  | m²
Tôle 5 mm | A15 passe-câble | 1 | 80 | 60 |  | m²
Tôle 3 mm | T04 chapes collier | 2 | 146 | 113 |  | m²
Tôle 3 mm | T05 ailes coude | 4 | 43 | 30 |  | m²
Tôle 3 mm | T06 ailes tête | 6 | 50 | 30 |  | m²
Tôle 3 mm | T07 fonds de chape | 5 | 30 | 30 |  | m²
Tôle 3 mm | T08 âmes de tête | 3 | 42 | 30 |  | m²
Tôle 3 mm | T09 joues de tête | 6 | 35 | 30 |  | m²
Tôle 3 mm | T10 plaques VESA | 3 | 120 | 120 |  | m²
Tôle 3 mm | T11 crochets | 3 | 80 | 18.6 |  | m²
Tôle 3 mm | T13 contre-plaque | 1 | 90 | 80 |  | m²
Tôle 4 mm | T12 supports QR | 3 | 80 | 80 |  | m²
Synthèse (à commander, +10 % chutes) |  |  |  |  | Total | +10 %
Tube carré 30×30×2
Tube rond Ø40×3
Tube rond Ø52×6
Plat 20×18
Rond Ø30
Rond alu Ø40
Tôle 5 mm
Tôle 3 mm
Tôle 4 mm

Sheet: Impression3D
Rep | Pièce | Qté | Matière | Volume (cm³) | Masse totale (g) | Filament Ø1,75 (m) | Réglages | Fichier STL
P01 | Bague de pivot | 8 | PA12 / Nylon | 1.89 |  |  | 100 %, debout, 4 périm., aléser Ø8 | P01_Bague_pivot_D12xD8x30_x8.stl
P02 | Bague d'inclinaison | 3 | PA12 / Nylon | 2.14 |  |  | 100 %, debout, aléser Ø8 | P02_Bague_inclinaison_D12xD8x34_x3.stl
P03 | Bague de rotation | 3 | PA12 / Nylon | 0.63 |  |  | 100 %, debout | P03_Bague_rotation_D12xD8x10_x3.stl
P04 | Patin de friction | 16 | PETG | 0.34 |  |  | 100 %, à plat, couche 0,12 | P04_Patin_friction_D24xD12x1_x16.stl
P05 | Rondelle de friction | 22 | PETG | 0.29 |  |  | 100 %, à plat | P05_Rondelle_friction_D16xD8.5x2_x22.stl
P06 | Rondelle de butée | 6 | PETG | 0.14 |  |  | 100 %, à plat, couche 0,12 | P06_Rondelle_butee_D16xD8.5x1_x6.stl
P07 | Cache de vis | 6 | PETG | 0.98 |  |  | 30 %, dôme en haut | P07_Cache_vis_D18x7_x6.stl
P08 | Embout de tube | 5 | PETG | 6.80 |  |  | 30 %, col à plat | P08_Embout_tube_30x30_x5.stl
P09 | Bouton de serrage | 5 | PETG | 4.90 |  |  | 40 %, cavité en bas, écrou M8 noyé | P09_Bouton_serrage_D28_x5.stl
P10 | Clip de câbles de mât | 1 | PETG | 14.20 |  |  | 30 %, debout | P10_Clip_cable_mat_x1.stl
P11 | Clip de câbles de bras | 4 | PETG | 5.98 |  |  | 30 %, sur le côté | P11_Clip_cable_bras_x4.stl
P12 | Patin d'étau | 1 | TPU 95A | 15.89 |  |  | TPU 100 %, à plat | P12_Patin_etau_TPU_76x106x2_x1.stl
P13 | Patin de contre-plaque | 1 | TPU 95A | 14.40 |  |  | TPU 100 %, à plat | P13_Patin_contreplaque_TPU_90x80x2_x1.stl
 | TOTAL
 | Les volumes sont ceux des pièces pleines ; la masse réelle dépend du remplissage.

Sheet: Charge
Paramètre | Valeur | Unité | Note
Masse max par écran | 9 | kg | Hypothèse 32" lourd (VESA 100)
Nombre d'écrans | 3
Bras de levier max (axe mât → centre écran) | 0.765 | m | Bras tendu : 340 + 370 + 55
Moment max un seul écran (cas déséquilibré) |  | N·m | Mât + soudure + étau
Charge totale écrans |  | kg
Module de flexion tube Ø40×3 |  | mm³
Contrainte mât (moment max) |  | MPa | S235 : Re = 235 MPa
Coefficient de sécurité mât |  |  | ≥ 3 recommandé
