bakirrayan/screen_support/STEP/Support_ecrans_assemblage.step

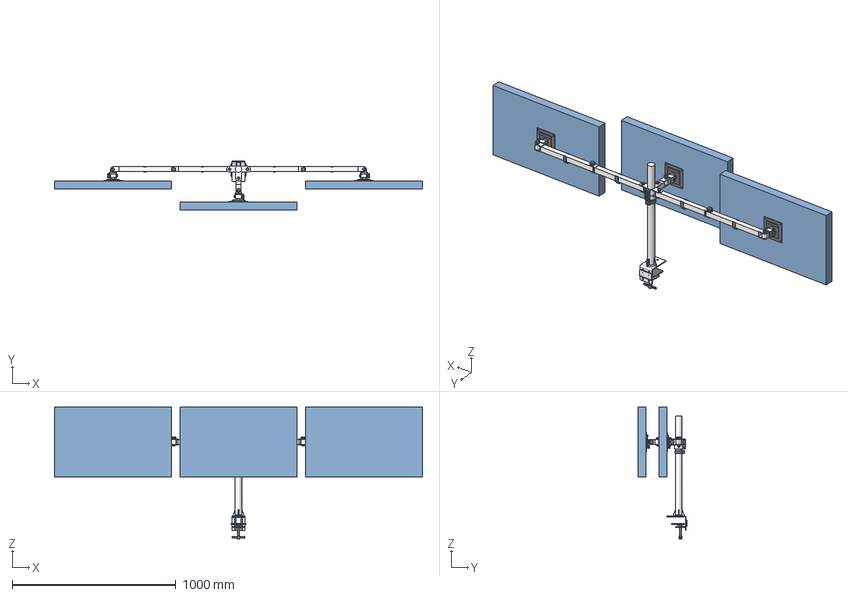
[picture p22: CAD file, 2026-11-08]
STEP/Support_ecrans_assemblage.step
2245.0 x 299.0 x 802.5 mm
Socle
Bras1 droit
Bras2 droit
Tete droite
Inclinaison droite
Ecran droit
Bras1 gauche
Bras2 gauche
Tete gauche
Inclinaison gauche
Ecran gauche
Bras centre
Tete centre
Inclinaison centre
Ecran centre
