bakirrayan/screen_support/DXF/T02_Etau_bas_acier5mm.dxf

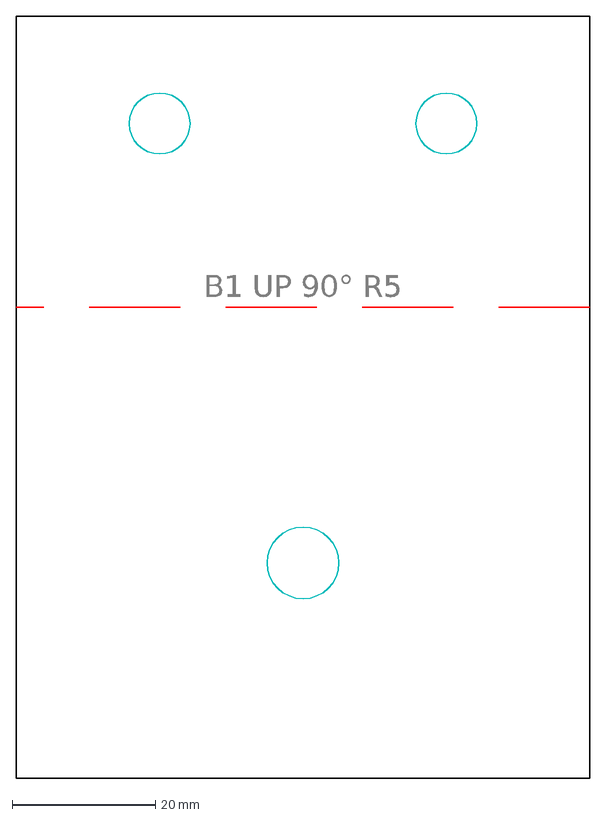
[picture p23: CAD file, 2026-11-08]
DXF/T02_Etau_bas_acier5mm.dxf
B1 UP 90° R5
