bakirrayan/screen_support/STL/P02_Bague_inclinaison_D12xD8x34_x3.stl

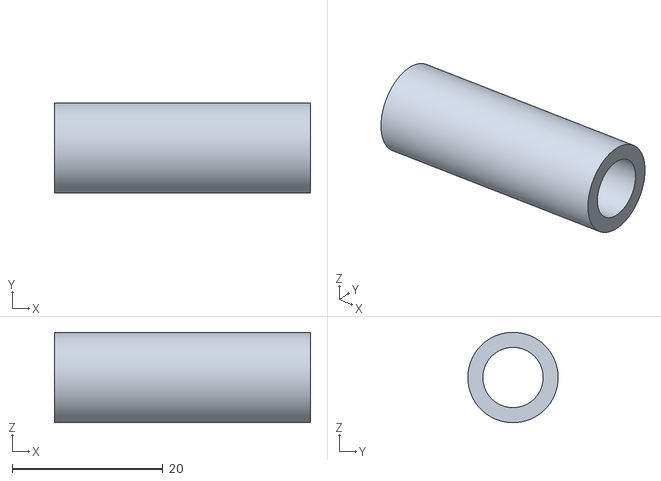
[picture p24: CAD file, 2026-11-08]
STL/P02_Bague_inclinaison_D12xD8x34_x3.stl
34.0 x 12.0 x 12.0
