bakirrayan/screen_support/DXF/T12_Support_QR_4mm_x3.dxf

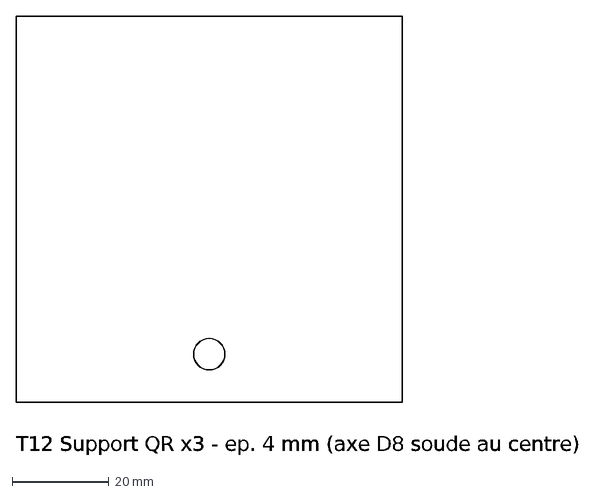
[picture p25: CAD file, 2026-11-08]
DXF/T12_Support_QR_4mm_x3.dxf
T12 Support QR x3 - ep. 4 mm (axe D8 soude au centre)
