bakirrayan/screen_support/STL/P13_Patin_contreplaque_TPU_90x80x2_x1.stl

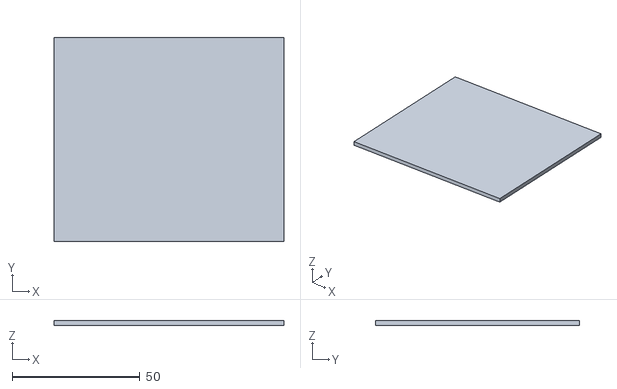
[picture p26: CAD file, 2026-11-08]
STL/P13_Patin_contreplaque_TPU_90x80x2_x1.stl
90.0 x 80.0 x 2.00
