bakirrayan/screen_support/DXF/T10_Plaque_VESA_3mm_x3.dxf

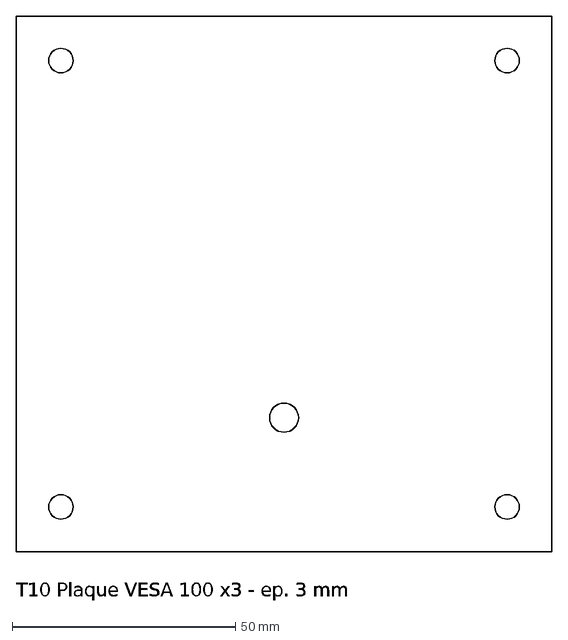
[picture p27: CAD file, 2026-11-08]
DXF/T10_Plaque_VESA_3mm_x3.dxf
T10 Plaque VESA 100 x3 - ep. 3 mm
