bakirrayan/screen_support/STL/P09_Bouton_serrage_D28_x5.stl

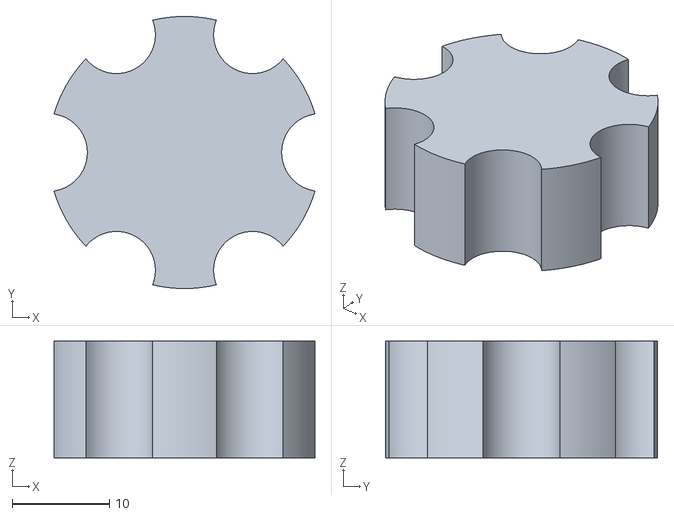
[picture p28: CAD file, 2026-11-08]
STL/P09_Bouton_serrage_D28_x5.stl
26.9 x 28.0 x 12.0
