bakirrayan/screen_support/DXF/T05_Aile_chape_coude_3mm_x4.dxf

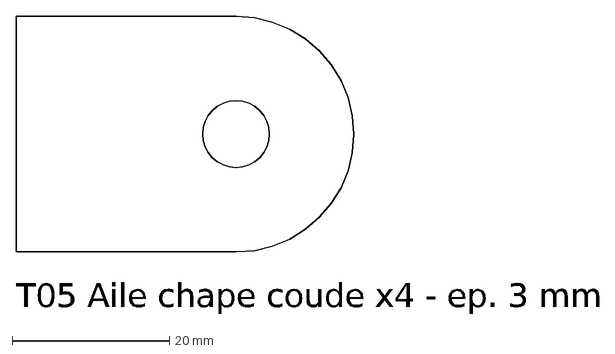
[picture p29: CAD file, 2026-11-08]
DXF/T05_Aile_chape_coude_3mm_x4.dxf
T05 Aile chape coude x4 - ep. 3 mm
