bakirrayan/screen_support/STL/P10_Clip_cable_mat_x1.stl

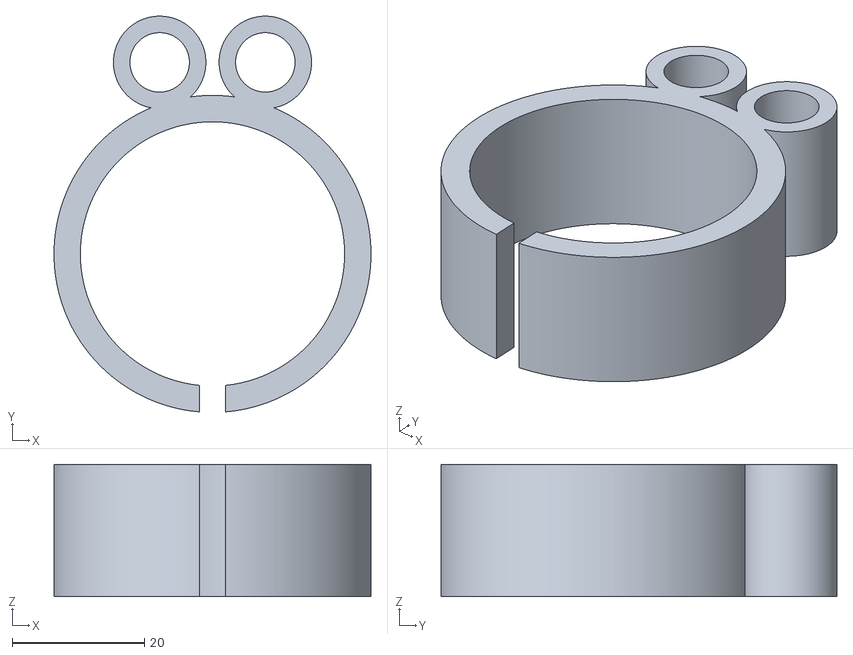
[picture p30: CAD file, 2026-11-08]
STL/P10_Clip_cable_mat_x1.stl
48.0 x 59.9 x 20.0
