bakirrayan/screen_support/DXF/T14_Plaque_passe_cable_5mm_x1.dxf

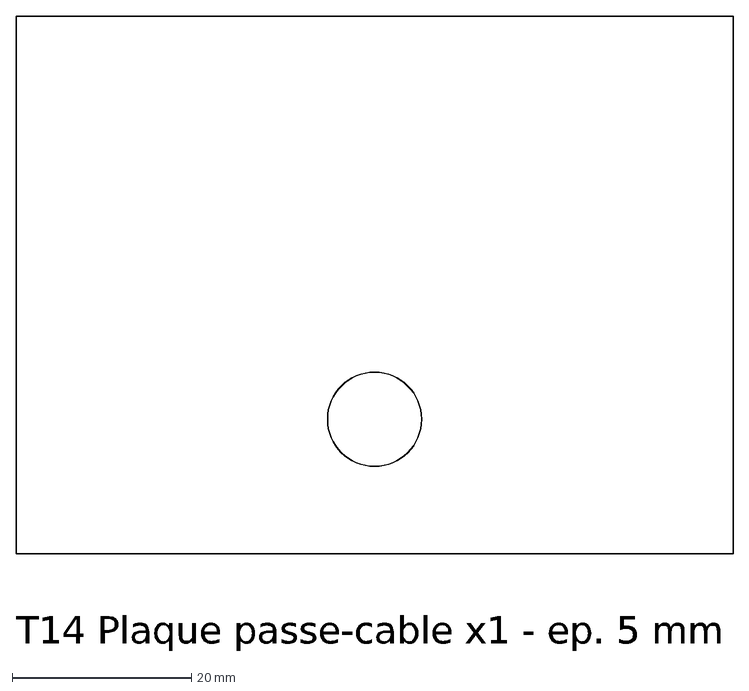
[picture p31: CAD file, 2026-11-08]
DXF/T14_Plaque_passe_cable_5mm_x1.dxf
T14 Plaque passe-cable x1 - ep. 5 mm
