bakirrayan/screen_support/STL/P07_Cache_vis_D18x7_x6.stl

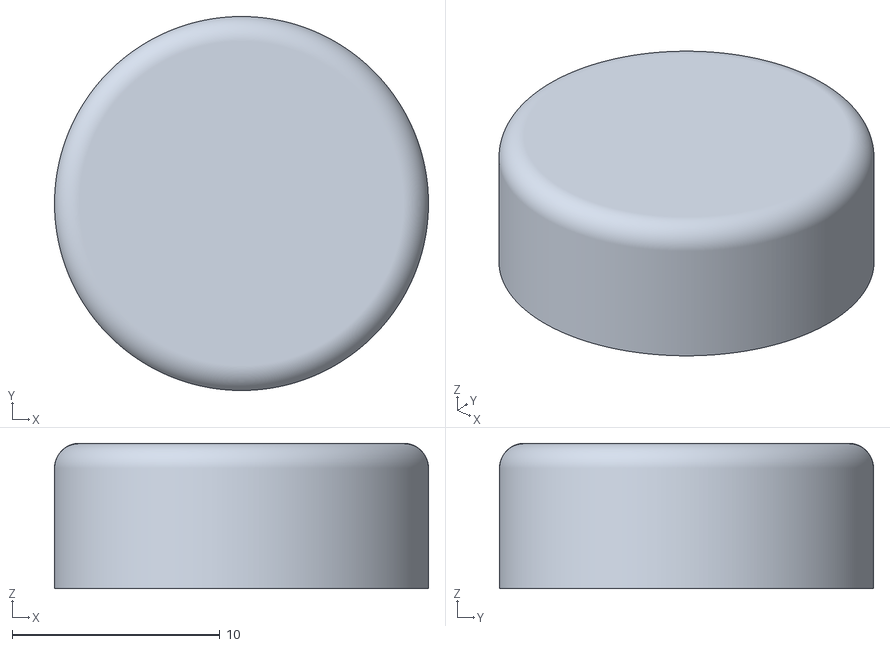
[picture p32: CAD file, 2026-11-08]
STL/P07_Cache_vis_D18x7_x6.stl
18.0 x 18.0 x 7.00
