bakirrayan/screen_support/DXF/T06_Aile_chape_tete_3mm_x6.dxf

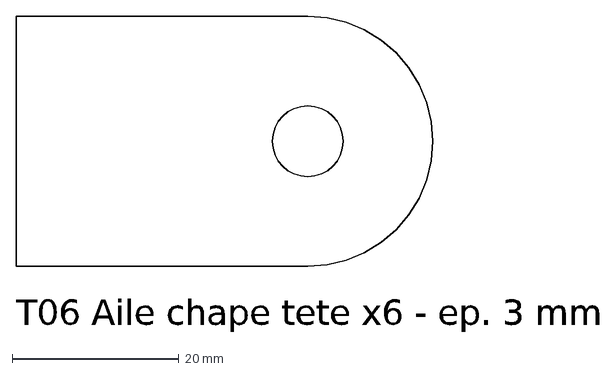
[picture p33: CAD file, 2026-11-08]
DXF/T06_Aile_chape_tete_3mm_x6.dxf
T06 Aile chape tete x6 - ep. 3 mm
