bakirrayan/screen_support/STL/P03_Bague_rotation_D12xD8x10_x3.stl

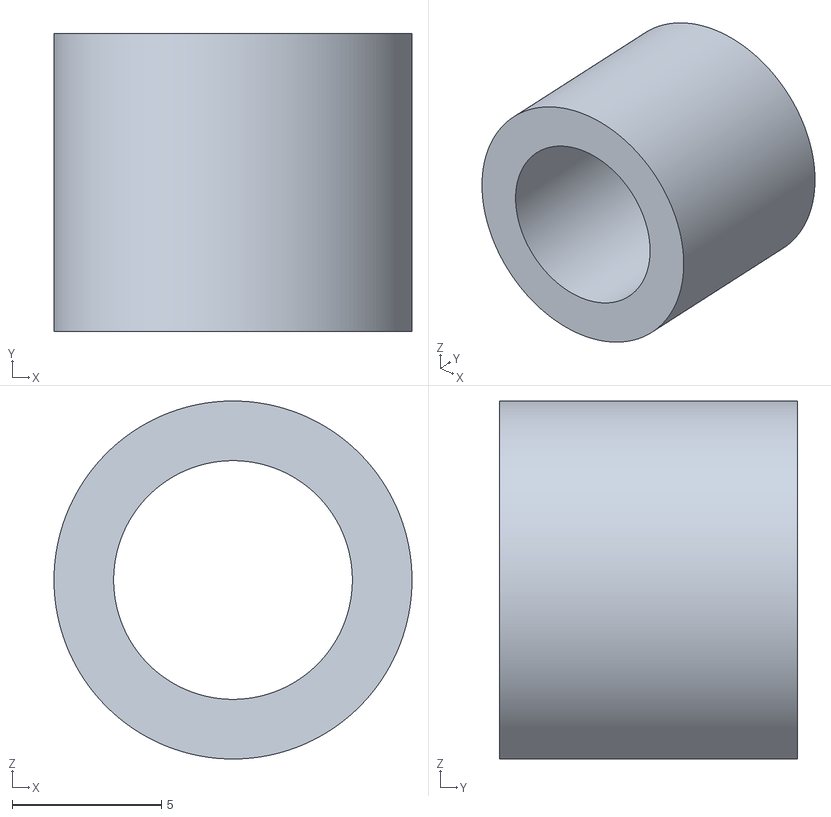
[picture p34: CAD file, 2026-11-08]
STL/P03_Bague_rotation_D12xD8x10_x3.stl
12.0 x 10.0 x 12.0
