bakirrayan/screen_support/DXF/T08_Ame_tete_3mm_x3.dxf

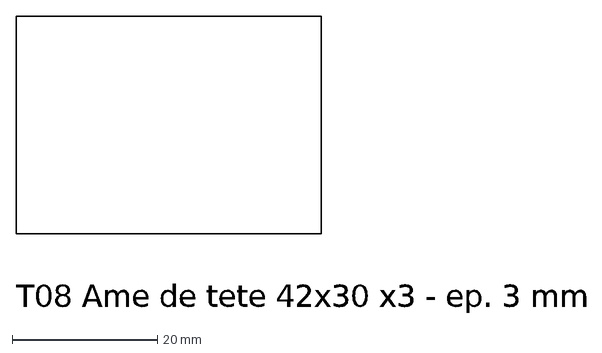
[picture p35: CAD file, 2026-11-08]
DXF/T08_Ame_tete_3mm_x3.dxf
T08 Ame de tete 42x30 x3 - ep. 3 mm
