bakirrayan/screen_support/STL/P04_Patin_friction_D24xD12x1_x16.stl

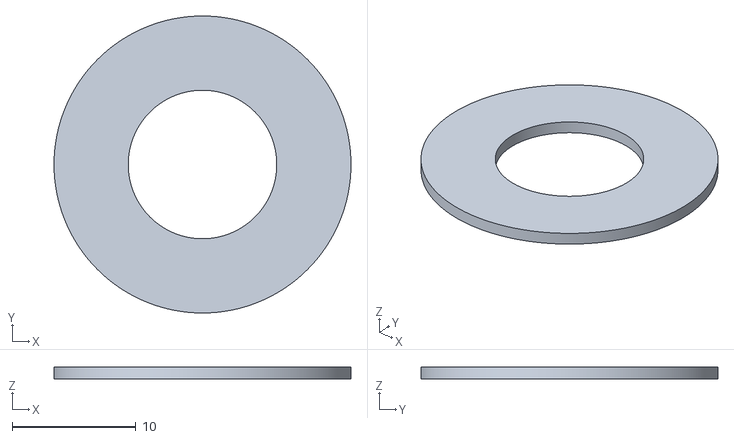
[picture p36: CAD file, 2026-11-08]
STL/P04_Patin_friction_D24xD12x1_x16.stl
24.0 x 24.0 x 1.00
