bakirrayan/screen_support/DXF/T09_Joue_tete_3mm_x6.dxf

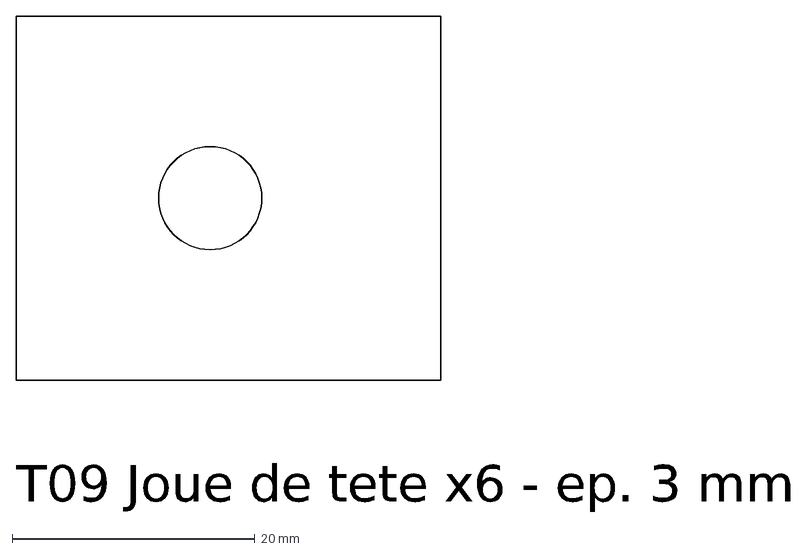
[picture p37: CAD file, 2026-11-08]
DXF/T09_Joue_tete_3mm_x6.dxf
T09 Joue de tete x6 - ep. 3 mm
