bakirrayan/screen_support/STL/P11_Clip_cable_bras_x4.stl

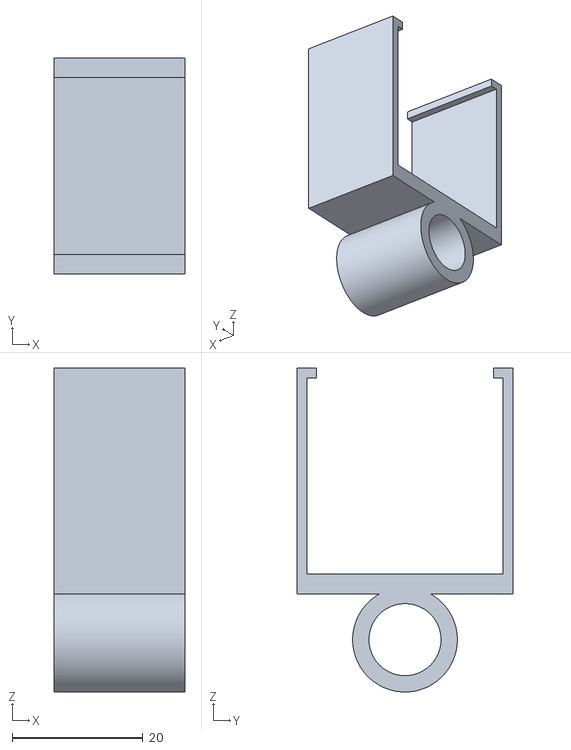
[picture p38: CAD file, 2026-11-08]
STL/P11_Clip_cable_bras_x4.stl
20.0 x 33.0 x 49.5
