bakirrayan/screen_support/DXF/T07_Fond_chape_3mm_x5.dxf

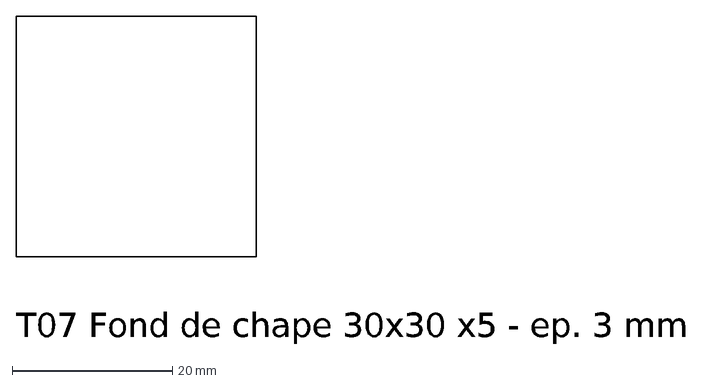
[picture p39: CAD file, 2026-11-08]
DXF/T07_Fond_chape_3mm_x5.dxf
T07 Fond de chape 30x30 x5 - ep. 3 mm
