bakirrayan/screen_support/STL/P01_Bague_pivot_D12xD8x30_x8.stl

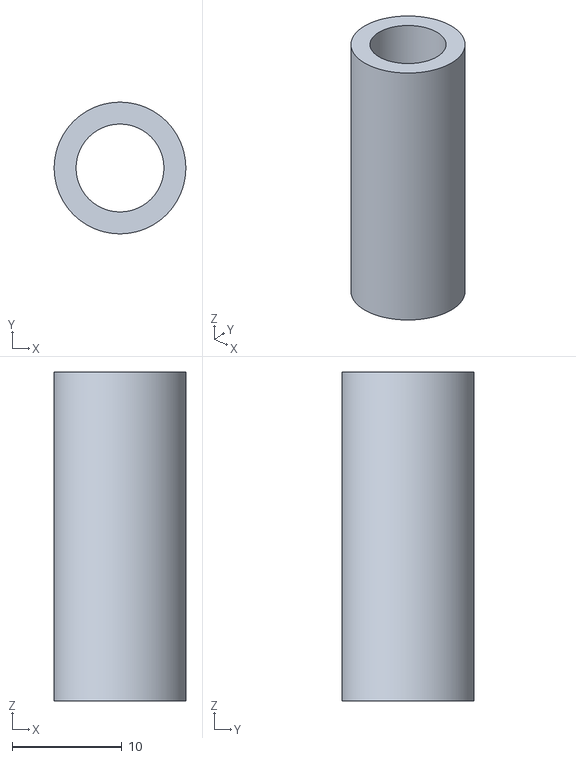
[picture p40: CAD file, 2026-11-08]
STL/P01_Bague_pivot_D12xD8x30_x8.stl
12.0 x 12.0 x 30.0
