bakirrayan/screen_support/DXF/T11_Crochet_QR_3mm_x3.dxf

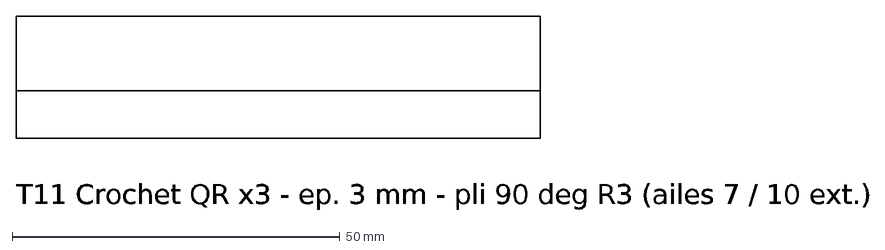
[picture p41: CAD file, 2026-11-08]
DXF/T11_Crochet_QR_3mm_x3.dxf
T11 Crochet QR x3 - ep. 3 mm - pli 90 deg R3 (ailes 7 / 10 ext.)
