bakirrayan/screen_support/STL/P12_Patin_etau_TPU_76x106x2_x1.stl

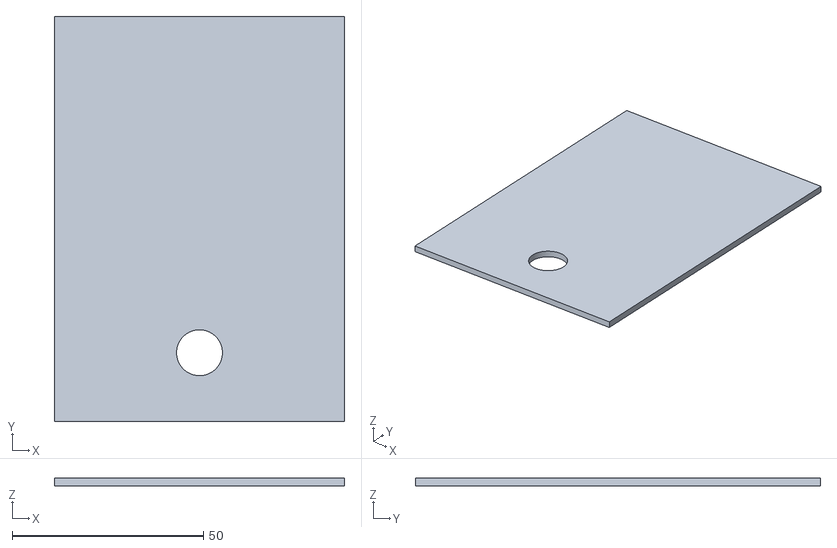
[picture p42: CAD file, 2026-11-08]
STL/P12_Patin_etau_TPU_76x106x2_x1.stl
76.0 x 106.0 x 2.00
