bakirrayan/screen_support/DXF/T04_Chape_collier_3mm_x2.dxf

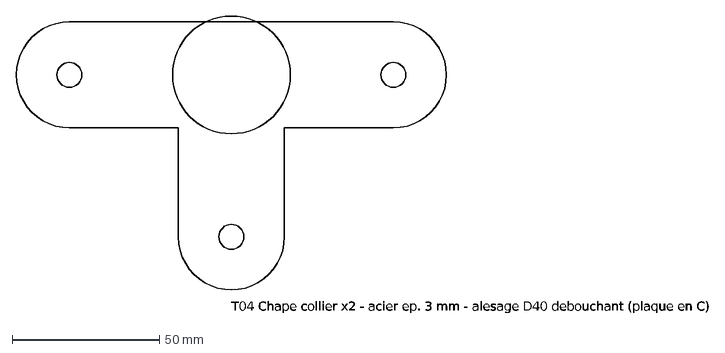
[picture p43: CAD file, 2026-11-08]
DXF/T04_Chape_collier_3mm_x2.dxf
T04 Chape collier x2 - acier ep. 3 mm - alesage D40 debouchant (plaque en C)
