bakirrayan/screen_support/STL/P08_Embout_tube_30x30_x5.stl

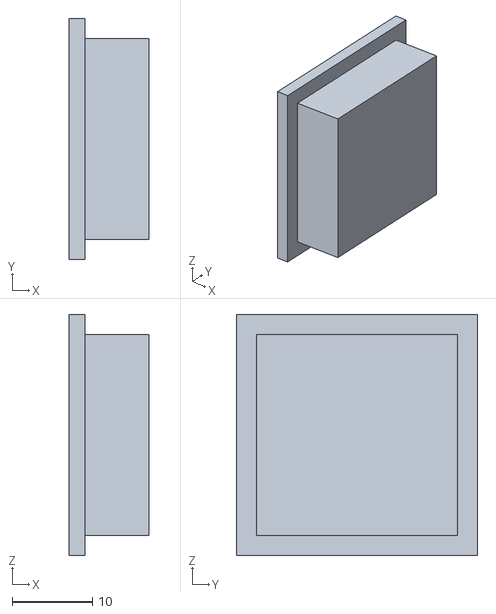
[picture p44: CAD file, 2026-11-08]
STL/P08_Embout_tube_30x30_x5.stl
10.0 x 30.0 x 30.0
