bakirrayan/screen_support/DXF/T01_Etau_haut_acier5mm.dxf

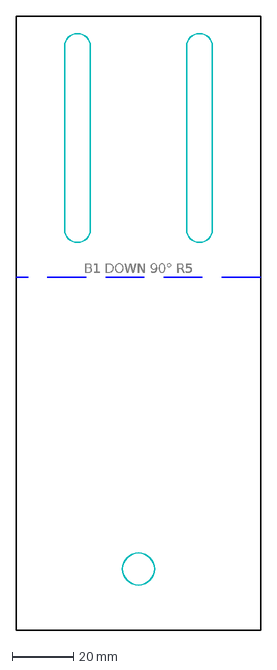
[picture p45: CAD file, 2026-11-08]
DXF/T01_Etau_haut_acier5mm.dxf
B1 DOWN 90° R5
