bakirrayan/screen_support/STL/P05_Rondelle_friction_D16xD8.5x2_x22.stl

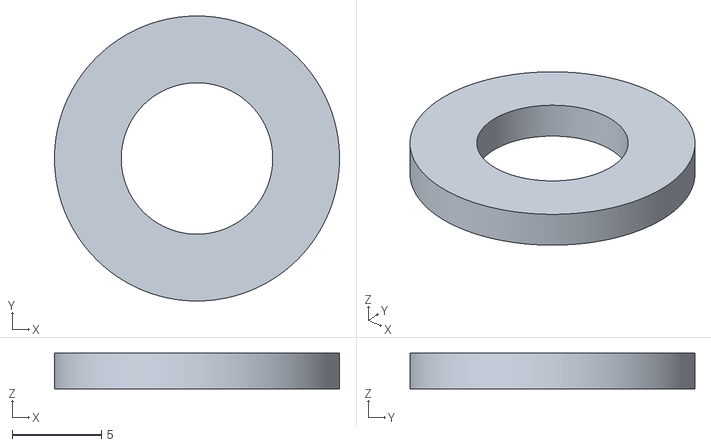
[picture p46: CAD file, 2026-11-08]
STL/P05_Rondelle_friction_D16xD8.5x2_x22.stl
16.0 x 16.0 x 2.00
