bakirrayan/screen_support/DXF/T13_Contreplaque_3mm_x1.dxf

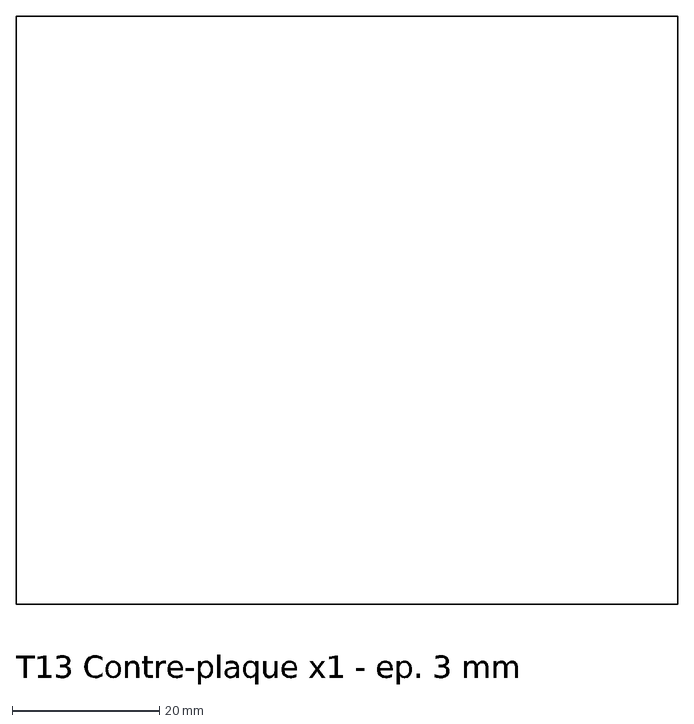
[picture p47: CAD file, 2026-11-08]
DXF/T13_Contreplaque_3mm_x1.dxf
T13 Contre-plaque x1 - ep. 3 mm
