bakirrayan/screen_support/STL/P06_Rondelle_butee_D16xD8.5x1_x6.stl

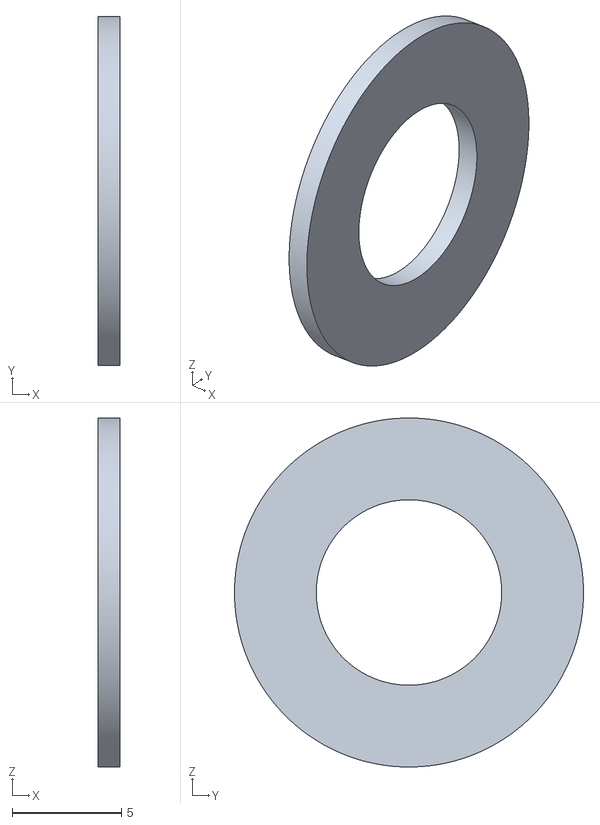
[picture p48: CAD file, 2026-11-08]
STL/P06_Rondelle_butee_D16xD8.5x1_x6.stl
1.00 x 16.0 x 16.0
