bakirrayan/screen_support/DXF/T03_Gousset_5mm_x4.dxf

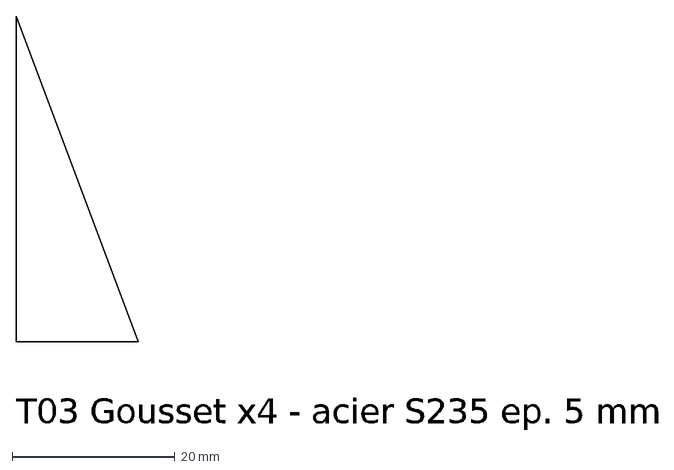
[picture p49: CAD file, 2026-11-08]
DXF/T03_Gousset_5mm_x4.dxf
T03 Gousset x4 - acier S235 ep. 5 mm
